SeriousD/SemesterProjekt/Projektbericht/dokumentation.tex

%%%%%%%%%%%%%%%%%%%%%%%%%%%%%%%%%%%%%%%%%
% University Assignment Title Page 
% LaTeX Template
% Version 1.0 (27/12/12)
%
% This template has been downloaded from:
% http://www.LaTeXTemplates.com
%
% Original author:
% WikiBooks (http://en.wikibooks.org/wiki/LaTeX/Title_Creation)
%
% License:
% CC BY-NC-SA 3.0 (http://creativecommons.org/licenses/by-nc-sa/3.0/)
% 
% Instructions for using this template:
% This title page is capable of being compiled as is. This is not useful for 
% including it in another document. To do this, you have two options: 
%
% 1) Copy/paste everything between \begin{document} and \end{document} 
% starting at \begin{titlepage} and paste this into another LaTeX file where you 
% want your title page.
% OR
% 2) Remove everything outside the \begin{titlepage} and \end{titlepage} and 
% move this file to the same directory as the LaTeX file you wish to add it to. 
% Then add \input{./title_page_1.tex} to your LaTeX file where you want your
% title page.
%
%%%%%%%%%%%%%%%%%%%%%%%%%%%%%%%%%%%%%%%%%
%\title{Title page with logo}
%----------------------------------------------------------------------------------------
%   PACKAGES AND OTHER DOCUMENT CONFIGURATIONS

%----------------------------------------------------------------------------------------

\documentclass[12pt]{article}
\usepackage[ngerman]{babel}
\usepackage[utf8x]{inputenc}
\usepackage{amsmath}
\usepackage{graphicx}
\usepackage[colorinlistoftodos]{todonotes}
\usepackage{float}
\restylefloat{table}
\usepackage{floatflt} 
\usepackage{fancyhdr}
\usepackage{subfigure}
\usepackage{microtype}
\usepackage{pdfpages}

\usepackage{pgfplots}
\usepackage{booktabs}

\setlength{\emergencystretch}{1em}
%\usepackage{showframe}% just for the example

%\usepackage{gnuplot-lua-tikz}
%\usepackage{pgfsys}
%\usepackage{keyval}
%\usepackage{xcolor}
%\usepackage{tikz}

\begin{document}
\begin{titlepage}

\newcommand{\HRule}{\rule{\linewidth}{0.5mm}} % Defines a new command for the horizontal lines, change thickness here

\center % Center everything on the page
%----------------------------------------------------------------------------------------
%   HEADING SECTIONS
%----------------------------------------------------------------------------------------

\textsc{\LARGE University of applied sciences Kiel}\\[1.5cm] % Name of your university/college
\textsc{\Large Semesterprojekt}\\[0.5cm] % Major heading such as course name
\textsc{\large }\\[0.5cm] % Minor heading such as course title

%----------------------------------------------------------------------------------------
%   TITLE SECTION
%----------------------------------------------------------------------------------------

\HRule \\[0.4cm]
{ \huge \bfseries Optische Übertragungsstrecke für das Hochspannungslabor im Fachbereich I\&E}\\[0.4cm] % Title of your document
\HRule \\[1.5cm]
 
%----------------------------------------------------------------------------------------
%   AUTHOR SECTION
%----------------------------------------------------------------------------------------

\begin{minipage}{0.4\textwidth}
\begin{flushleft} \large
\emph{Autor:}\\
Clemens \textsc{Büsch}\\
Dennis \textsc{Ernst}
\end{flushleft}
\end{minipage}
~
\begin{minipage}{0.4\textwidth}
\begin{flushright} \large
\emph{Betreuer:} \\
Prof. Dr. Kay \textsc{Rethmeier} % Supervisor's Name
\end{flushright}
\end{minipage}\\[2cm]

% If you don't want a supervisor, uncomment the two lines below and remove the section above
%\Large \emph{Author:}\\
%John \textsc{Smith}\\[3cm] % Your name

%----------------------------------------------------------------------------------------
%   DATE SECTION
%----------------------------------------------------------------------------------------

{\large \today}\\[2cm] % Date, change the \today to a set date if you want to be precise
	
\newcommand{\CM}[1]{\makebox[0pt]{\begin{tabular}{l}#1\end{tabular}}} 
%----------------------------------------------------------------------------------------
%   LOGO SECTION
%----------------------------------------------------------------------------------------

%\includegraphics{logo.png}\\[1cm] % Include a department/university logo - this will require the graphicx package
 
%----------------------------------------------------------------------------------------

\vfill % Fill the rest of the page with whitespace

\end{titlepage}
%\pagestyle{fancy}
%\lfoot{\textsc{Semesterprojekt}:\\ {\footnotesize Optische Übertragungsstrecke für das Hoch-\\spannungslabor im Fachbereich I\&E}}

\tableofcontents

\newpage

\input{einleitung}
\input{uebertragsungsverfahren}
\input{projektstruktur}
\input{vcc}
\input{eingangstufe}
\input{millerintegrator}
\input{comp}
\input{diodentreiber}

\input{demodulation}
\input{recv}
\input{preamp}
\input{tiefpass}
\input{endstufe}

\input{simTx}
\input{simRx}

\input{measurements}
\input{justierung}
\input{appendix}

\listoffigures

\end{document}
