SeriousD/SemesterProjekt/Projektbericht/uebertragsungsverfahren.tex

\section{Übertragungsverfahren}
Das zu übertragende Signal ist ein analoges Messignal mit Netzfrequenz, welches von der Hochspannungsanlage stammt. Die Amplitude wird durch den Eingangswiderstand der Sendeeinheit bestimmt. Die zur Verfügung stehenden Dioden können analoge sowie digitale Signale übertragen. Aufgrund dessen stehen mehrere Übertragungsverfahren zur Auswahl.
In diesem Kapitel werden einige in Frage kommende Übertragungsverfahren vorgestellt und evaluiert.
\subsection{Analoge Übertragungsarten}
\subsubsection{Direkte Übertragung}
Eine Möglichkeit das Signal zu übertragen ist, dieses nach Aufbereitung direkt auf die Dioden zu geben.
Durch diese Anordnung ist jedoch nicht garantiert, dass das Messignal bei variierender Länge des Lichtwellenleiters mit gleicher Amplitude rekonsturiert werden kann. Die Dämpfung des Lichtwellenleiters erfordert eine Kalibration auf verschiedene Längen der Übertragungs\-strecke.
\subsubsection{Frequenzmodulation}
\begin{figure}[H]
\centering
  %\scalebox{0.7}{\begin{large}$\input{fm.tex}$\end{large}}
  \input{gfx/modulations/FM.pgf}
  \caption{Frequenzmodulation}
  \label{fig:fm}
\end{figure}
Die Frequenzmodulation verändert die Frequenz des Trägersignals linear zur Amplitude des Nachrichtensignals.
Eine Implementierung einer solchen Modulation ist mit einem Voltage contolled oscillator (VCO) simpel zu realisieren. Die Demodulation erfolgt über einen Diskriminator, welcher auf vielfältige Art und Weise aufgebaut werden kann. Exemplarisch sei an dieser Stelle die Demodulation mit einem Phase locked loop (PLL) genannt. Eine PLL führt die Ausgangsfrequenz immer einer gegeben Eingangsfrequenz nach. Die Regeldifferenz aus diesen Größen lässt sich als Spannung abgreifen. Wird ein frequenzmoduliertes Signal als Soll-Signal vorgegeben so ist die genannte Regelspannung das demodulierte Nachrichtensignal.

\subsubsection{Amplitudenmodulation}
\begin{figure}[H]
\centering
  %\scalebox{0.7}{\begin{large}$\input{am.tex}$\end{large}}
  \input{gfx/modulations/AM.pgf}
  \caption{Amplitudenmodulation}
  \label{fig:am}
\end{figure}
Die Amplitudenmodulation verändert die Amplitude des Trägersignals proportional zum Nachrichtensignal.
Eine Amplitudenmodulation lässt sich durch Anwendung eines 4 Quadranten-Mischers unkompliziert implementieren. Zur Modulation werden lediglich ein Trägersignal, welches eine vielfache Frequenz des Nachrichtensignals haben muss, und das Nachrichtensignal multiplizert. Anschließend werden unerwünsche Mischprodukte herausgefiltert. Die Demodulation erfolgt über einen Tiefpass, dessen Grenzfrequenz weit unter der gewählten Trägerfrequenz liegt.
Da bei dieser Modulation die Information genauso wie bei der direkten Übertragung in der Amplitude liegt, entstehen wieder die gleichen Probleme durch die Dämpfung des Lichtwellenleiters.

\subsection{Digitale Übertragungsarten}
\subsubsection{Pulsweitenmodulation}
\begin{figure}[H]
\centering
  %\scalebox{0.7}{\begin{large}
  %$\input{pwm.tex}$
  %\end{large}}
  \input{gfx/modulations/PWM.pgf}
  \caption{Pulsweitenmodulation}
  \label{fig:pwm}
\end{figure}
Die Pulsweitenmodulation moduliert, ähnlich wie die Frequenzmodulation, das Nachrichtensignal im Zeitbereich. 
Die essentiellen Unterschiede liegen zum Einen darin, dass die PWM ein digitales Übertragungsverfahren ist und demnach nur 2 Zustände kennt, und zum Anderen, dass das Nachrichtensignal nicht direkt in der Frequenz sondern in der Pulsweite des Trägersignals kodiert wird. Die Synthese einer Pulsweitenmodulation kann durch den Vergleich des Nachrichtensignals mit einer Dreiecksspannung erfolgen. Hierbei ist darauf zu achten, dass die Dreieckspannung, welche als Träger verwendet wird, eine vielfache Frequenz des Nachrichtensignals aufweist. Die Demodulation eines pulsweitenmodulierten Signals erfolgt durch einen Tiefpass, welcher ledglich das Nachrichtensignal im Passband hat. 

\subsection{Wahl des Übertragungsverfahren}
Eine unmodulierte Übertragung ist aufgrund der Leitungsdämpfung ausgeschlossen. Entsprechend kommt folgender genereller Systemaufbau in Frage.
\begin{figure}[H]
\centering
  \input{prinzip.pdf_tex}
  \caption{Genereller Systemaufbau}
  \label{fig:psystem}
\end{figure}
Die Evaluation der drei verbliebenen Varianten liefert die Pulsweitenmodulation (PWM) als optimales Ergebnis:Im Gegensatz zu allen analogen Übertragungsverfahren lässt sich die PWM durch Übersteuerung des Eingangsverstärkers der Empfängereinheit sehr einfach rekonstruieren und ist demnach unempfindlich gegenüber Variationen der Dämpfung der Leitungslänge. Darüber hinaus ist die Synthese sowie Demodulation einer PWM mit einfachen Mitteln umzusetzen.\\
Neben den grundlegenden Aufgaben des Systems, wie Modulation und Demodulation, müssen noch weitere Komponenten wie eine Endstufe und eine Schutzschaltung gegenüber der Hochspannung im System verbaut werden. 
Aus allen vorangegangen Überlegungen geht folgender Systemaufbau hervor: 
\begin{figure}[H]
  \centering
  \scalebox{0.97}{
  \input{systemaufbau.pdf_tex}}
  \caption{Systemaufbau}
  \label{fig:system}
\end{figure}

\subsection{Pulsweitenmodulation - Theorie}
\label{sec:pwmTheory}
Im wesentlichen basiert die Funktionsweise einer PWM auf der Variation des Tastverhältnisses einer Rechteckspannung. Durch die Änderung des Tastverhältnis wird der Effektivwert der Rechteckspannung verändert, dieser berechnet sich wie folgt:
\begin{equation}
 U_{eff} = \sqrt{\frac{1}{T}\cdot\int\limits_{0}^T u(t)^2 dt}
\end{equation}
Offensichtlich ist der Effektivwert von dem Integral der Kurve über eine Periode, also der Fläche unter der Kurve, abhängig. Diese Fläche wird wie bereits beschrieben über das Tastverhältnis bestimmt. So kann jede Perdiode des Rechteckssignals als ein Abstastwert des Nachrichtensignals interpretiert werden. Dieses Integral ist beispielhaft für 2 Perioden eines Sinussignals in Abbildung \ref{fig:pwmArea} dargestellt. Aufgrund dieser Abtastung ist es wichtig, dass zur optimalen Rekonstruktion das 50 Hz Eingangssignal um ein Vielfaches abgetastet wird. Für diese Anwendung wurde eine 200-fache Überabtastung von $f_A=10kHz$ gewählt.
\begin{figure}[H]
  \centering
   %\scalebox{0.6}{\begin{Large}
   %\input{pwmArea.tex}
   %\end{Large}}
   \input{gfx/modulations/PWMarea.pgf}
   \caption{Pulsweitenmodulation Illustration}
  \label{fig:pwmArea}
\end{figure}

\newpage
