SeriousD/SemesterProjekt/Projektbericht/projektstruktur.tex

\section{Projektstruktur}
Das Projekt wird in folgende Teilprobleme zerlegt. 
\begin{figure}[H]
\centering
  \scalebox{0.85}{
 \input{projektstruktur.pdf_tex}}
	\caption{Projektstruktur}
\end{figure}
Im Laufe der Projektarbeit wird jedes einzelne Teilproblem mit Komponententests validiert. Schlussendlich wird das Gesamtsystem getestet.
