SeriousD/SemesterProjekt/Projektbericht/dokumentation.pdf

University of applied sciences Kiel

Semesterprojekt

# Optische Ubertragungsstrecke ¨ fur das Hochspannungslabor im ¨ Fachbereich I&E

### Autor: Clemens Busch ¨ Dennis Ernst

### Betreuer: Prof. Dr. Kay

Rethmeier

### 21. Februar 2017

## Inhaltsverzeichnis

1 Einleitung | | 2
2 Ubertragungsverfahren | 2 ¨
2.1 Analoge Ubertragungsarten | ¨ | 2
2.1.1 | Direkte Ubertragung | ¨ | 2
2.2 Digitale Ubertragungsarten | ¨ | 5
2.3 Wahl des Ubertragungsverfahren | ¨ | 6
3 Projektstruktur | 8
4 Schaltungsentwurf - Sendeeinheit | 8
5 Schaltungsentwurf - Empfangseinheit | 13
6 Simulation kritischer Schaltungsteile | 22

1

## 1 Einleitung

Im Hochspannungslabor des Fachbereichs Informatik und Elektrotechnik werden die Messsignale aus dem zum elektrischen Schutz aufgebauten Hochspannungskäfig per BNC Leitung nach außen an die Messgeräte gefuhrt. ¨ Die Messgeräte und insbesondere die zufuhrenden Leitungen haben keinen ¨
Beruhrungsschutz, was unmittelbar ein Gefahrenpotential f ¨ | ur die Experimen- ¨
tatoren durch Uberschl ¨ | äge in die Messleitung birgt.
Aufgrund dieser Gefahr soll eine optische Signalsubertragungsstrecke mit ei- ¨ nem Lichtwellenleiter realisiert werden.
Zur Verfugung stehen dazu Hochgeschwindigkeitssende- und Empfangsdi- ¨ oden von des Herstellers Avago (HFBR1414 und HFBR2416).

## 2 Ubertragungsverfahren ¨

Das zu ubertragende Signal ist ein analoges Messignal mit Netzfrequenz, ¨ welches von der Hochspannungsanlage stammt. Die Amplitude wird durch den Eingangswiderstand der Sendeeinheit bestimmt. Die zur Verfugung ste- ¨ henden Dioden können analoge sowie digitale Signale ubertragen. Aufgrund ¨ dessen stehen mehrere Ubertragungsverfahren zur Auswahl. In diesem Kapi- ¨ tel werden einige in Frage kommende Ubertragungsverfahren vorgestellt und ¨ evaluiert.

### 2.1 Analoge Ubertragungsarten ¨

### 2.1.1 Direkte Ubertragung ¨

Eine Möglichkeit das Signal zu ubertragen ist, dieses nach Aufbereitung di- ¨ rekt auf die Dioden zu geben. Durch diese Anordnung ist jedoch nicht garantiert, dass das Messignal bei variierender Länge des Lichtwellenleiters mit gleicher Amplitude rekonsturiert werden kann. Die Dämpfung des Lichtwellenleiters erfordert eine Kalibration auf verschiedene Längen der Ubertragungs- ¨ strecke.

2

### 2.1.2 Frequenzmodulation

-15

-10

-5

0

5

10

15

0 | 0.01 | 0.02 | 0.03 | 0.04 | 0.05 | 0.06

-6

-4

-2

0

2

4

6

0 | 0.01 | 0.02 | 0.03 | 0.04 | 0.05 | 0.06

-6

-4

-2

0

2

4

6

0 | 0.01 | 0.02 | 0.03 | 0.04 | 0.05 | 0.06

u

m/V

t/s

Nachrichtensignal

uc/V

t/s

Trägersignal

ufm/V

t/s

Frequenzmoduliertes Signal

Abbildung 1: Frequenzmodulation

Die Frequenzmodulation verändert die Frequenz des Trägersignals linear zur Amplitude des Nachrichtensignals. Eine Implementierung einer solchen Modulation ist mit einem Voltage contolled oscillator (VCO) simpel zu realisieren. Die Demodulation erfolgt uber einen Diskriminator, welcher auf ¨ vielfältige Art und Weise aufgebaut werden kann. Exemplarisch sei an dieser Stelle die Demodulation mit einem Phase locked loop (PLL) genannt. Eine PLL fuhrt die Ausgangsfrequenz immer einer gegeben Eingangsfrequenz ¨ nach. Die Regeldifferenz aus diesen Größen lässt sich als Spannung abgreifen. Wird ein frequenzmoduliertes Signal als Soll-Signal vorgegeben so ist die genannte Regelspannung das demodulierte Nachrichtensignal.

3

### 2.1.3 Amplitudenmodulation

-15

-10

-5

0

5

10

15

0 | 0.01 | 0.02 | 0.03 | 0.04 | 0.05 | 0.06

-6

-4

-2

0

2

4

6

0 | 0.01 | 0.02 | 0.03 | 0.04 | 0.05 | 0.06

-30

-20

-10

0

10

20

30

0 | 0.01 | 0.02 | 0.03 | 0.04 | 0.05 | 0.06

u

m/V

t/s

Nachrichtensignal

uc/V

t/s

Trägersignal

uam/V

t/s

Amplitudenmoduliertes Signal

Abbildung 2: Amplitudenmodulation

Die Amplitudenmodulation verändert die Amplitude des Trägersignals proportional zum Nachrichtensignal. Eine Amplitudenmodulation lässt sich durch Anwendung eines 4 Quadranten-Mischers unkompliziert implementieren. Zur Modulation werden lediglich ein Trägersignal, welches eine vielfache Frequenz des Nachrichtensignals haben muss, und das Nachrichtensignal multiplizert. Anschließend werden unerwunsche Mischprodukte herausgefiltert. Die De- ¨ modulation erfolgt uber einen Tiefpass, dessen Grenzfrequenz weit unter der ¨ gewählten Trägerfrequenz liegt. Da bei dieser Modulation die Information genauso wie bei der direkten Ubertragung in der Amplitude liegt, entstehen ¨ wieder die gleichen Probleme durch die Dämpfung des Lichtwellenleiters.

4

### 2.2 Digitale Ubertragungsarten ¨

### 2.2.1 Pulsweitenmodulation

-15

-10

-5

0

5

10

15

0 | 0.01 | 0.02 | 0.03 | 0.04 | 0.05 | 0.06

-15

-10

-5

0

5

10

15

0 | 0.01 | 0.02 | 0.03 | 0.04 | 0.05 | 0.06

-0.5

0

0.5

1

1.5

0 | 0.01 | 0.02 | 0.03 | 0.04 | 0.05 | 0.06

u

m/V

t/s

Nachrichtensignal

uc/V

t/s

Trägersignal

upwm/V

t/s

Pulsweitenmoduliertes Signal

Abbildung 3: Pulsweitenmodulation

Die Pulsweitenmodulation moduliert, ähnlich wie die Frequenzmodulation, das Nachrichtensignal im Zeitbereich. Die essentiellen Unterschiede liegen zum Einen darin, dass die PWM ein digitales Ubertragungsverfahren ist und ¨ demnach nur 2 Zustände kennt, und zum Anderen, dass das Nachrichtensignal nicht direkt in der Frequenz sondern in der Pulsweite des Trägersignals kodiert wird. Die Synthese einer Pulsweitenmodulation kann durch den Vergleich des Nachrichtensignals mit einer Dreiecksspannung erfolgen. Hierbei ist darauf zu achten, dass die Dreieckspannung, welche als Träger verwendet wird, eine vielfache Frequenz des Nachrichtensignals aufweist. Die Demodulation eines pulsweitenmodulierten Signals erfolgt durch einen Tiefpass,

5

welcher ledglich das Nachrichtensignal im Passband hat.

### 2.3 Wahl des Ubertragungsverfahren ¨

Eine unmodulierte Ubertragung ist aufgrund der Leitungsd ¨ | ämpfung ausge-
schlossen. Entsprechend kommt folgender genereller Systemaufbau in Frage.
Modulator | LWL-
Ubertragung ¨

Demodulator Nutzsignal

Trägersignal

Nutzsignal

Trägersignal

Abbildung 4: Genereller Systemaufbau

Die Evaluation der drei verbliebenen Varianten liefert die Pulsweitenmodulation (PWM) als optimales Ergebnis: Im Gegensatz zu allen analo-
gen Ubertragungsverfahren l ¨ | ässt sich die PWM durch Ubersteuerung des ¨
Eingangsverstärkers der Empfängereinheit sehr einfach rekonstruieren und
ist demnach unempfindlich gegenuber Variationen der D ¨ | ämpfung der Lei-
tungslänge. Daruber hinaus ist die Synthese sowie Demodulation einer PWM ¨ mit einfachen Mitteln umzusetzen.
Neben den grundlegenden Aufgaben des Systems, wie Modulation und Demodulation, mussen noch weitere Komponenten wie eine Endstufe und eine ¨ Schutzschaltung gegenuber der Hochspannung im System verbaut werden. ¨ Aus allen vorangegangen Uberlegungen geht folgender Systemaufbau hervor: ¨

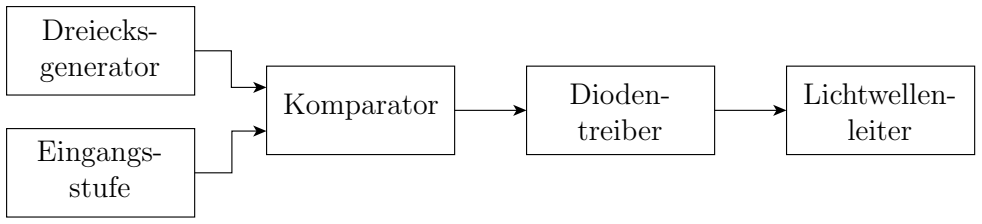
[picture p9: figure]
Komparator; Eingangs- stufe; Dreiecks- generator; Dioden- treiber; Lichtwellen- leiter

Endstufe

Butterworth-tiefpass

Signalaufbereitung

Empfangseinheit:

Sendeeinheit:

Lichtwellenleiter

Abbildung 5: Systemaufbau

6

### 2.4 Pulsweitenmodulation - Theorie

Im wesentlichen basiert die Funktionsweise einer PWM auf der Variation des Tastverhältnisses einer Rechteckspannung. Durch die Anderung des Tast- ¨ verhältnis wird der Effektivwert der Rechteckspannung verändert, dieser berechnet sich wie folgt:

Uef f =

### vuuut

1
T

·

Z

T

0

u(t)

2dt | (1)

Offensichtlich ist der Effektivwert von dem Integral der Kurve uber eine ¨ Periode, also der Fläche unter der Kurve, abhängig. Diese Fläche wird wie
bereits beschrieben uber das Tastverh ¨ | ältnis bestimmt. So kann jede Perdiode
des Rechteckssignals als ein Abstastwert des Nachrichtensignals interpretiert werden. Dieses Integral ist beispielhaft fur 2 Perioden eines Sinussignals in ¨ Abbildung 6 dargestellt. Aufgrund dieser Abtastung ist es wichtig, dass zur optimalen Rekonstruktion das 50 Hz Eingangssignal um ein Vielfaches abge-
tastet wird. Fur diese Anwendung wurde eine 200-fache ¨ | Uberabtastung von ¨
fA = 10kHz gewählt.

-0.5

0

0.5

1

1.5

0 | 0.005 | 0.01 | 0.015 | 0.02 | 0.025 | 0.03 | 0.035 | 0.04

upwm/V

t/s

Pulsweitenmoduliertes Signal

Abbildung 6: Pulsweitenmodulation Illustration

7

## 3 Projektstruktur

Das Projekt wird in folgende Teilprobleme zerlegt.

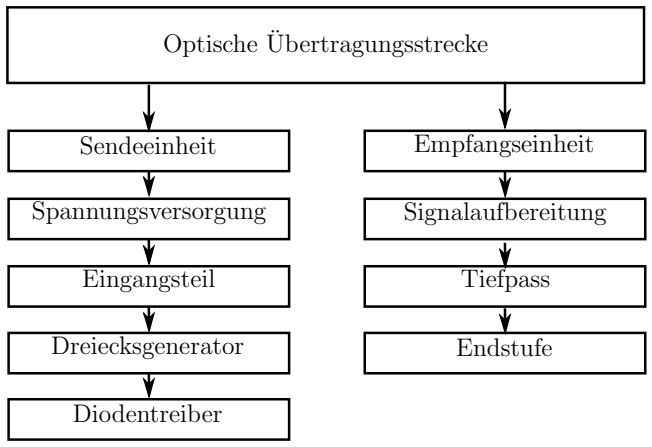
[picture p10: figure]
Optische Ubertragungsstrecke ¨; Sendeeinheit; Empfangseinheit; Signalaufbereitung; Endstufe; Spannungsversorgung; Eingangsteil; Dreiecksgenerator; Diodentreiber; Tiefpass

Abbildung 7: Projektstruktur

Im Laufe der Projektarbeit wird jedes einzelne Teilproblem mit Komponententests validiert. Schlussendlich wird das Gesamtsystem getestet.

## 4 Schaltungsentwurf - Sendeeinheit

### 4.1 Spannungsversorgung

Die Spannungsversorgung fur die Sen- ¨

Ext. Supply

7809

7909 | GND

X2-1 1

X2-2 2

X2-3 3

GND

VI 1

2

VO 3

GND
VI 2

1
VO 3

V+

V-

Abbildung 8: Spannungsversorgung deeinheit erfolgt zur galvanischen Trennung uber Batterien. Aufgrund der ho- ¨ hen Stromaufnahme durch die Sendediode sowie der Status-LEDs ist eine interne Versorgung uber 9V Blockbat- ¨ terien nur bedingt möglich. Deswegen
wird auf eine externe Versorgng uber ¨
12V Akkus zuruckgegriffen. Damit die ¨
Schaltung dennoch bei allen Akkuspannungen zuverlässig und mit gleichen Ergebnissen arbeitet wird die Spannung intern auf 9V stabilisiert.

8

### 4.2 Eingangsstufe

SL2

1

2

3

R1 | R5
A | E

S R11

AE

S

R12

R13 | D2 D3
F1

C8
AC_IN
1k | 1k

50k

20k
S14K11
7,5

7,5

100n

GND | GND

Abbildung 9: Kaskade

Die Eingangsstufe der Sendeeinheit dient einerseits zur Einstellung der gewunschten ¨ Impedanz und andererseits der Schaltung der folgenden Komponenten. Beiden Potentiometer (R12 , R13) werden durch einen Kippschalter an der Front
des Geräts umgeschaltet. Die folgenden 3 Schaltungsteile, welche durch 1kΩ Widerstände miteinander verbunden sind dienen dem Kurzschluss von Uberspannungen. ¨ Der Gasableiter ist mit einer Druchbruchspannung von 60V gewählt, der Varistor S14K11 ist mit einer AC-Durchbruchspannung von 11V gewählt und
die Zenerdioden mit einer Zenerspannung von 7, 5V dimensioniert.
Diese Schaltungs-Topologie sorgt fur einen zuverl ¨ | ässigen Schutz gegenuber ¨
Uberspannungen. Die Zener-Dioden, schalten am schnellsten und sind ent- ¨ sprechend am nähesten zur zu schutzenden Komponente verortet. Der Va- ¨ ristor spricht langsamer als die Zener-Dioden an, jedoch schneller als der Gasableiter. Die einzelnen Schutzbauteile sind der Verlustleistung und der Ansprechzeit nach absteigend in Richtung der folgenden Schaltungsteile angeordnet.

Abbildung 10: Spannungsversorgung

egergsfgsreghtsrhdt

9

### 4.3 Dreiecksgenerator

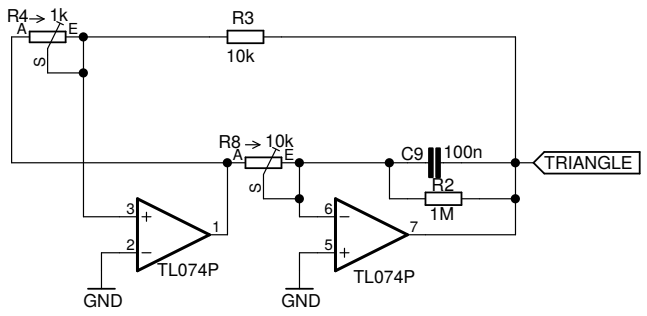
[picture p11: figure]
TRIANGLE; GND

Abbildung 11: Miller Integrator

Fur die Generierung eines Dreiecksignals wurde ein Miller-Integrator verwen- ¨ det. Die Grundlage fur die Schaltung liegt in einer Applicationnote von TI ¨

1
Das Grundprinzip dieser Schaltung besteht aus einem Intergrator, welcher auf einen invertierenden Schmitt-Trigger ruckgekoppelt ist. Der linke Ope- ¨ rationsverstärker bildet mit R4 und R3 den Schmitt-Trigger. Der Integrator besteht aus R8,C1 und dem rechten Operationsverstärker in Abbildung 12. Frequenzbestimmend sind in dieser Schaltung alle Bauteile. Durch R4 und R3 werden die Schaltschwellen, und damit die Amplitude bestimmt. Diese berechnet sich wie folgt:

UH = ±

R3
R4
- Vcc | (2)

Mit R8 und C1 wird die Flankensteilheit(k) in V
s

bestimmt:

k =

Vcc
R8 · C1

(3)

Die Frequenz des Dreieckssignals berechnet sich zu:

f =

R4
4 · R8 · R3 · C1

(4)

C1 wurde mit 33nF fest gewählt. Uein ist die Betriebspannung(Vcc), welche mit 9V gewählt wurde.

1Texas Instruments,Appnote 20, Seite 24, www.ti.com/lit/an/snoa621c/snoa621c.pdf

10

### 4.4 Komparator

Der Komparator bildet das Kernstuck ¨

TL074

13

12

### 14 TRIANGLE SIGNAL

### PWM

Abbildung 12: Komparator

zur Pulsweitenmodulation. Im wesentlichen vergleicht diese Komponente das im Dreiecksgenerator erzeugte Signal
mit dem Eingangssignal und generiert
damit die PWM (vgl. Abbildung 3).
Die Spezifikationen des fur diese Aufgabe gew ¨ | ählten Operationsverstärkers
sind von großer Bedeutung fur die Funktionsf ¨ | ähigkeit und Skalierbarkeit des
Gesamtsystems. Neben dem Stromverbrauch, der Betriebsspannung und der Slew-Rate ist auch die Beschaffbarkeit des Operationsvertärkers ein entschei-
dender Faktor. Fur diese Anwendung wurde deswegen der TL074 gew ¨ | ählt,
dieser zum einen durch die verwendete MOS-Technologie eine geringe Stromaufnahme von < 14mA aufweist und zum Anderen mit einer Slew-Rate von 1V/µs fur diese Anwendung bestens geeignet ist. ¨

### 4.5 Diodentreiber

Als Sendediode wird die Hochleistungs-

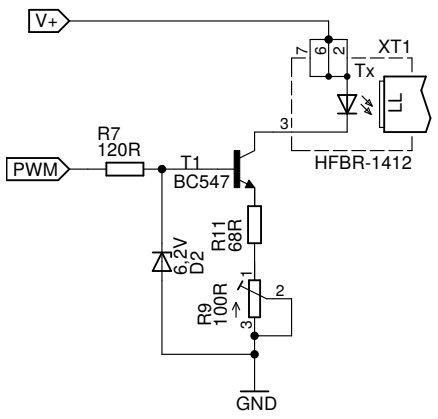
[picture p12: figure]
HFBR-1412; GND; PWM

Abbildung 13: Diodentreiber diode HFBR-1412 verwendet. Diese benötigt minimal 30mA und maximal 120mA. Da eine Diode ein Halbleiter ist, hat diese iene exponentielle Spannungs-Strom Kennlinie. Bei einer Versorgung mit konstanter Spannung kann durch thermische Ruckkopplung der Strom, ¨ und damit die Verlustleistung, unkontrolliert ansteigen. Dies kann zur Zerstörung des Bauteils fuhren. Aufgrund ¨ dessen wird der Diodentreiber als Konstantstromquelle (KSQ) ausgefuhrt. ¨
Die KSQ besteht aus T1, R11, R9 und
D2. Der Widerstand R7 dient lediglich der Begrenzung des Basisstromes von T1 und der Strombegrenzung von D2. Die Zener-Diode D2 hält die Spannung
uber der BE-Strecke von ¨ | T1 und den Widerständen R11 und R9 konstant. Da
die Spannng uber den Widerst ¨ | änden konstant ist, ist auch der Strom durch

11 diese konstant. Daraus folgt, dass auch der Kollektorstrom von T1 und somit auch der Strom durch die Leistungsdiode konstant ist. Der Strom berechnet sich wie folgt.

Ikonst =

Uz − UBE
R9 + R11

(5)

Durch den Reihenwiderstand R11 ist sichergestellt, dass auch bei Anschlag der Potentiometers zu 0Ω der Strom nicht 130mA ubersteigt. Der gesamte ¨
Einstellbereich fur den Diodenstrom liegt bei 36 ¨ | mA < Ikonst < 110mA.

## 5 Schaltungsentwurf - Empfangseinheit

Die Demodulation des Signals erfolgt im wesentlichen durch eine Tiefpass-Filterung. Das gesendete Signal muss allerdings erst vorbereitet werden. Dies geschieht durch eine Vorfilterung und anschließende Verstärkung. Ein Hochpass direkt am Ausgang der Empfangsdiode filtert DC-Anteile. Danach wird die Signalamplitude soweit verstärkt, dass der Signalverlauf wieder komplett
rechteckig dem urspruglichen PWM-Signal entsprechend verl ¨ | äuft. Dadurch
wird die nachfolgende rekonstruierende Filterung durch den Butterworth-Tiefpass erst möglich.
Schlussendlich wird das zuruckgewonnene Signal nach dem Rekonstruktions- ¨ filter mit einer einstellbaren Endstufe final verstärkt, damit die Amplitude dem des gesendeten Signals entspricht.

### 5.1 Beschaltung der Empfangsdiode

Fur die Empfangsdiode ¨ | AVAGO HFBR-2416 ist folgendes Prinzipschalt-
bild aus dem Datenblatt² gegeben:

2Avago, HFBR-2416, Seite 23, Figure 12 http://docs.avagotech.com/docs/AV02-0176EN

12

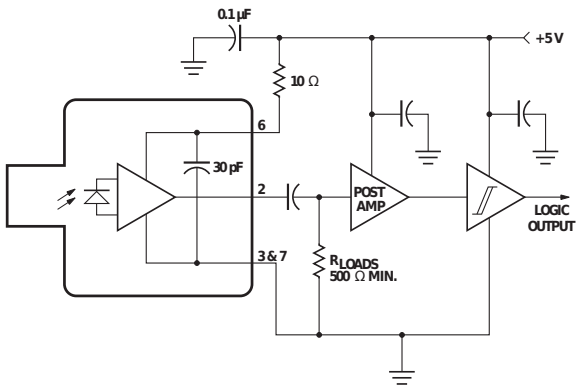
[picture p13: figure]
LOGIC OUTPUT; RLOADS 500 Ω MIN.; POST AMP

Abbildung 14: Prinzipschaltbild Empfangsdiode

Die | Prinzipschaltung | wurde
ubernommen, um den Betrieb ¨
innerhalb | der | Spezifikationen
zu gewährleisten. Die Bauteile sind so dimensioniert, dass die
Grenzfrequenz | des | Hochpasses
aus R4 und C5 unter dem Nachrichtensignal bei 50Hz liegt. Der Hochpass dient der Filterung von DC-Offsets seitens der Diode.
Fur ¨ | R4 | wurde 33kΩ gewählt.
Damit ergibt sich eine neue Grenzfrequenz von fg = 48, 23Hz.

Berechnung des Hochpasses:

Mit C5 = 100nF und fg = 50Hz folgt:

fg =

1
2π · R · C

(6)

R =

1
2π · fg · C

(7)

R =

1
2π · 50Hz · 100nF

(8)

= 31, 83kΩ | (9)

13

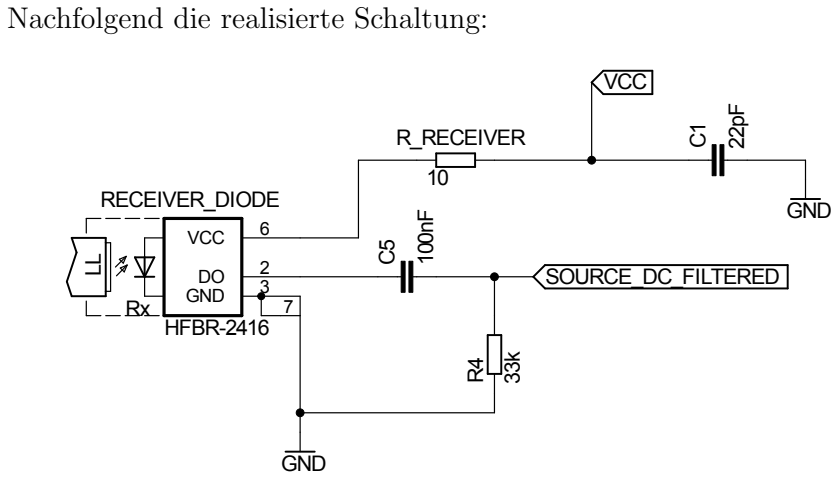
[picture p14: figure]
Nachfolgend die realisierte Schaltung:; GND; HFBR-2416; R_RECEIVER R⁴; RECEIVER_DIODE; VCC; SOURCE_DC_FILTERED

Abbildung 15: Beschaltung Empfangsdiode

14

### 5.2 Signalaufbereitung

Aufgrund der Leitungsdämpfung muss die Amplitude des modulierten Signals vor der Filterung durch den Rekonstruktionsfilter verstärkt werden (siehe Kapitel 5.1 - Abbildung 15: Postamp).Das Signal wird uber einen ¨

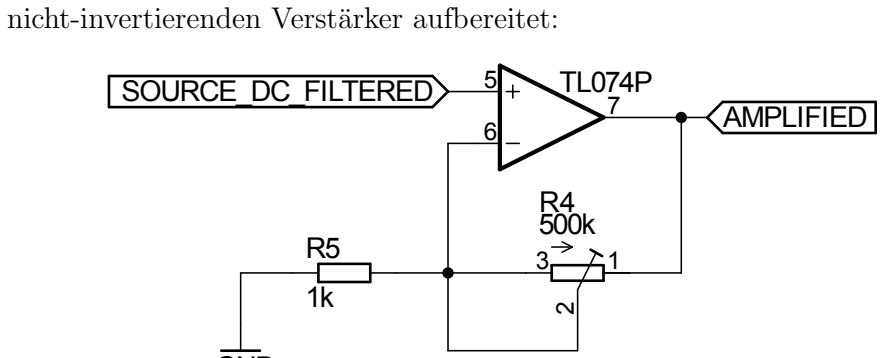
[picture p15: figure]
nicht-invertierenden Verstärker aufbereitet:; AMPLIFIED SOURCE_DC_FILTERED

### GND

Abbildung 16: Vorverstärker

Damit die Schaltung fur verschiedene Leitungsl ¨ | ängen skalierbar ist, wurde
eine variable Verstärkung bis zu einem Faktor von Vu = 500 gewählt.

VU = 1 +

R4
R5

(10)

R4
R5
>> 1 | (11)

VU ≈

R4
R5

(12)

Fur große Verst ¨ | ärkungen errech-
net(siehe Formel12³
) ist die 1 beim
Nicht-Invertierenden Verstärker zu vernachlässligen. Die Verstärkung berechnet sich lediglich aus den beiden Widerständen R5 und R4.

Mit 0Ω < R4 < 500kΩ und R5 = 1kΩ ist die Verstärkung von 0 bis 500 einstellbar.

Neben der Signalaufbereitung fur die folgende Demodulation, wird das ver- ¨ stärkte Signal auch fur eine Signaldetektion aufbereitet. Zur Signalisierung ¨ wird eine Leuchtdiode an der Gehäusefront verwendet. Zur Glättung der Spannung wird ein Kondensator parallel zu der Leuchtdiode mit Vorwiderstand geschaltet. Eine weitere Aufbereitung ist an dieser Stelle nicht not-

3Quelle: Elektronik Vorlesungssunterlagen, Prof. Dr. Ralf Patz

15 wendig, da das Trägersignal, als auch das Nachrichtensignal ≥ 50Hz ist und somit fur das menschliche Auge kein Flackern auftritt. ¨

16

### 5.3 Tiefpass

Die Dimensionierung des Tiefpasses ist von zentraler Bedeutung bei der Rekonstruktion des Nachrichtensignals. Neben der Filtersteilheit und der Restwelligkeit sind Kennwerte wie Ausgangs- und Eingangswiderstand wichtig fur die optmale Gestaltung des Tiefpasses. ¨

### 5.3.1 Filtercharakteristiken im Vergleich

Bei aktiven und mehrstufigen Fil-

gfx/characteristics.png

Abbildung 18: Filtercharakteristiken tertopologien gibt es eine große Auswahl an Fitlercharakteristiken, welche sich durch verschiedene Eigenschaften auszeichnen. Kennwerte fur ¨ diese Charakteristiken sind Linearphasigkeit, Gruppenlaufzeit, sowie Restwelligkeit im Pass-und Sperrband. In Abbildung 19 sind einige Charakteristiken beispielhaft dargestellt. Fur die Rekonstruktion wird ¨
eine Butterworth-Charakteristik gewählt, da diese im Passband eine konstante Verstärkung aufweist, sowie keinen Peak kurz vor der Grenzfrequenz hat.

### 5.3.2 Dimensionierung des Filters

Zur Dimensionierung des Filters wurde die Designsoftware FilterPro von Texas Instruments verwendet. Als Designparameter wurden neben der Butterworth-Charakteristik, eine Verstärkung von 0dB, eine Dämpfung von 9dB je Dekade (Filter 3. Ordnung), Bauteile der E12 Reihe, eine Grenzfrequenz von fg = 100Hz und eine Multiple-Feedback Topologie vorgegeben. Diese Topologie hat im Gegensatz zur Sallen-Key Topologie den Vorteil eines hohen Ausgangswiderstandes. Die Verstärkung von 0dB wird gewählt, da eine Endstufe mit variabler Verstärkung dieser Komponente folgt.

17


Abbildung 19: Auszug Design Report

Der Designreport zeigt die gewunschten Filterparameter. Besonders wich- ¨ tig an dieser Stelle ist die benötigte Unity-Gain (Gain-Bandwidth-Product), welche sich mit maximal 10kHz innerhalb der Spezifikationen vom TL074
befinden. Daruber hinaus wurde aufgrund besserer Beschaffbarkeit ¨ | C2 zu
1µF gewählt.

18

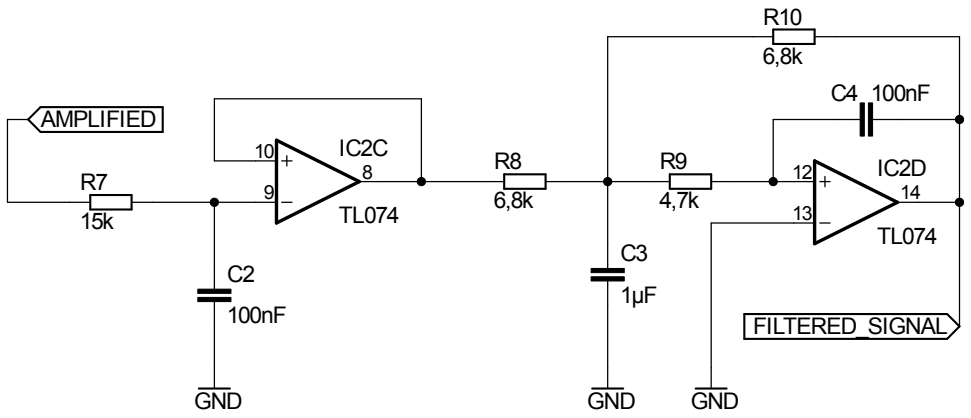
[picture p16: figure]
GND; FILTERED_SIGNAL; AMPLIFIED

Abbildung 20: Butterworth-Tiefpass

Der Widerstand R7 und der Kondensator C2 bilden als passiver Tiefpass die erste Filterstufe. Diese ist mit dem linken Operationsverstärker, welcher als Spannungsfolger beschaltet ist von der nachfolgenden zweiten Filterstufe entkoppelt. Mit R8 und C3 folgt ein weiterer passiver Tiefpass. Der letzte Teil des Filters ist ein aktiver Tiefpass, der sich aus dem zweiten Operationsverstärker und den Widerständen R9 ,R10, sowie dem Kondensator C4 zusammensetzt.

### 5.4 Endstufe

Der letzte Teil der Empfangseinheit besteht aus einem weiteren Verstärker und einem vorgeschalteten Hochpass. Der Hochpass hat eine Grenzfrequenz von fg ≈ 1, 59Hz und dient der Filterung vorangegangener DC-Offsets. Wie in Kapitel 5.2 bereits gezeigt, ist die Verstärkung ausschließlich von den beiden Widerständen abhänging. Die Verstärkung der Endstufe ist somit uber ¨ das Potentiometer von 0 bis 50 einstellbar.

19

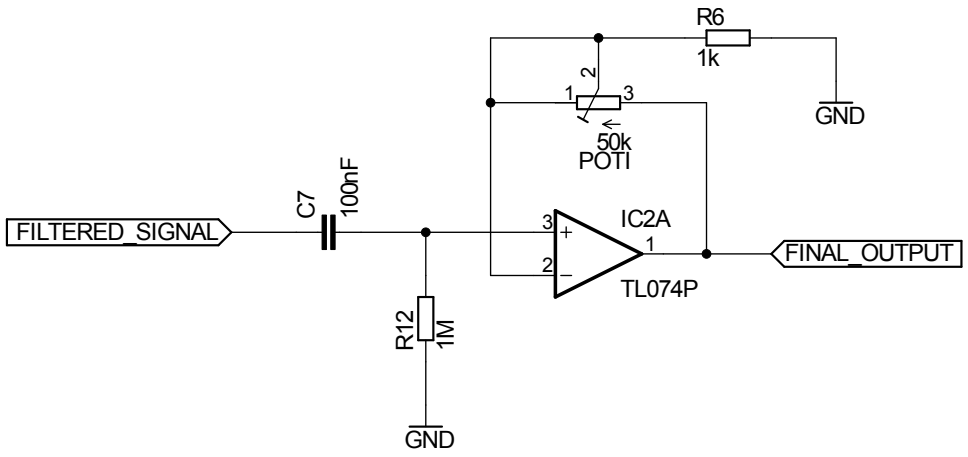
[picture p17: figure]
GND; POTI; FINAL_OUTPUT FILTERED_SIGNAL

Abbildung 21: Endstufe

20

## 6 Simulation kritischer Schaltungsteile

### 6.1 Sendeeinheit

### 6.1.1 Eingangsteil

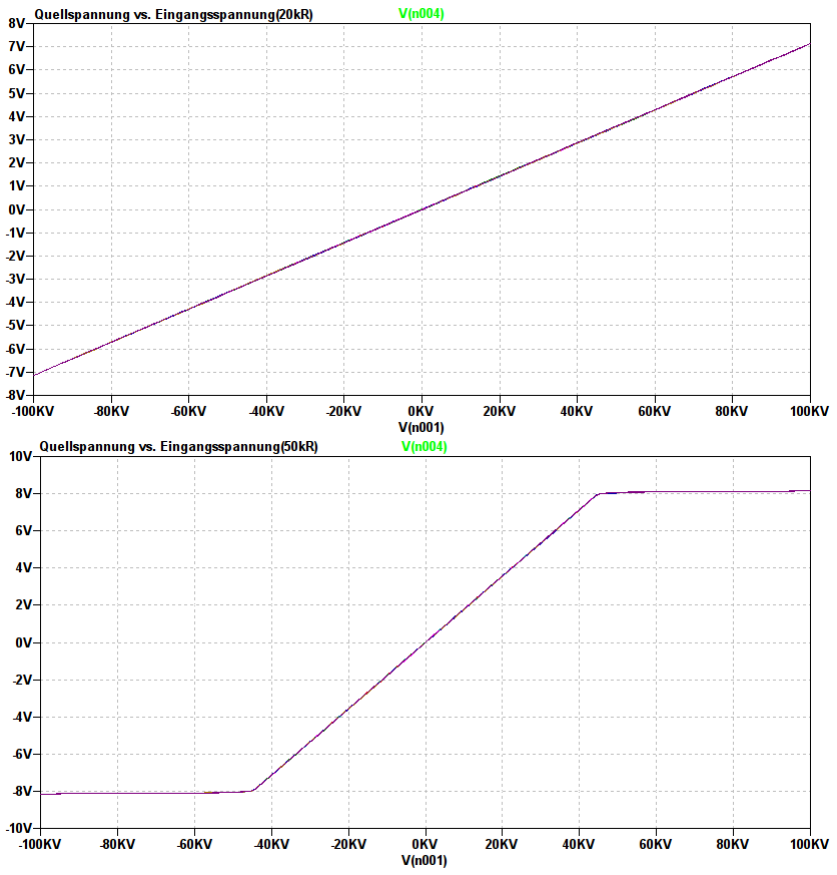
[picture p18: figure]

21

### 6.1.2 Millerintegrator


22

### 6.1.3 Diodentreiber


23

### 6.2 Empfangseinheit

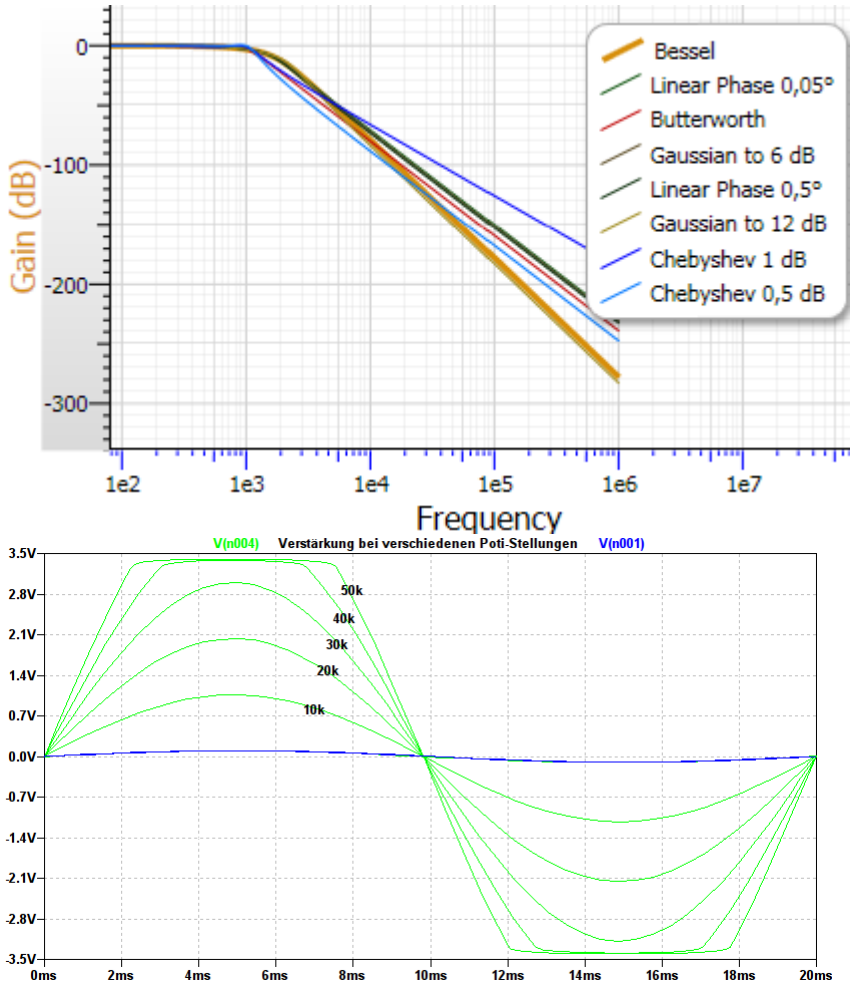
[picture p19: figure]

24

## Abbildungsverzeichnis

25
