SeriousD/SemesterProjekt/Projektbericht/gfx/triangle_generator.pdf

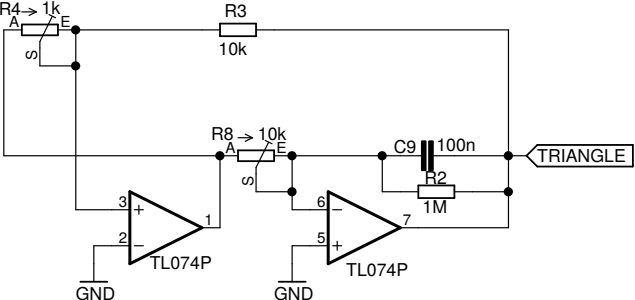
[picture p20: figure]
TRIANGLE; GND
