SeriousD/SemesterProjekt/Projektbericht/gfx/diodentreiber.pdf

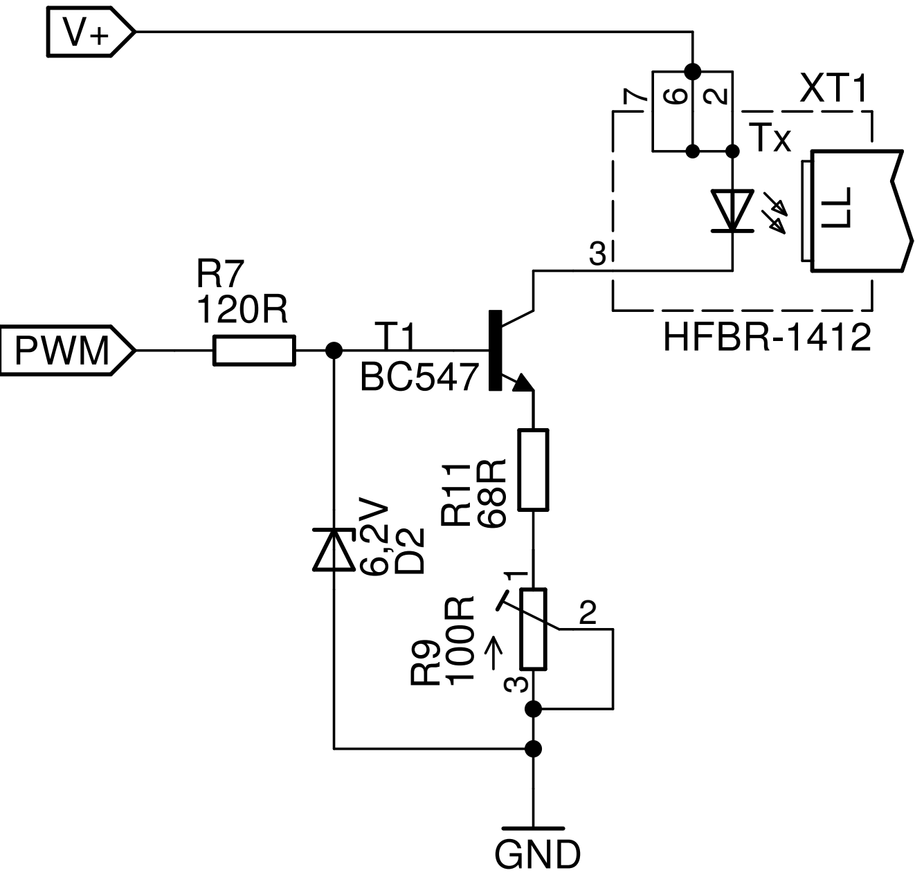
[picture p21: figure]
HFBR-1412; GND; PWM
