SeriousD/SemesterProjekt/Projektbericht/gfx/detect.pdf

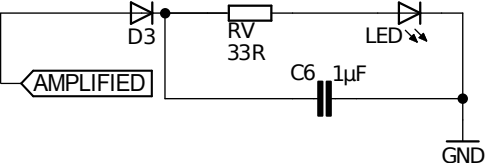
[picture p22: figure]
GND; LED; AMPLIFIED
