SeriousD/SemesterProjekt/Projektbericht/gfx/post_amplifier.pdf

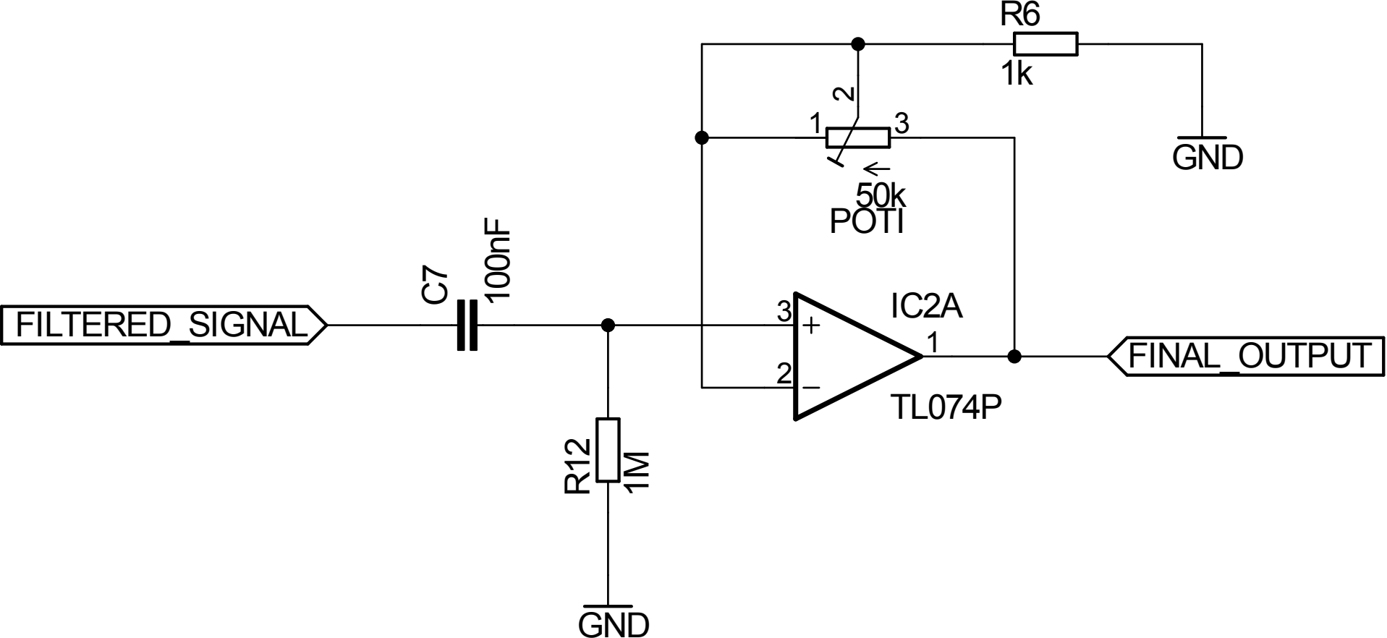
[picture p23: figure]
GND; POTI; FINAL_OUTPUT FILTERED_SIGNAL
