SeriousD/SemesterProjekt/Projektbericht/gfx/preamp.pdf

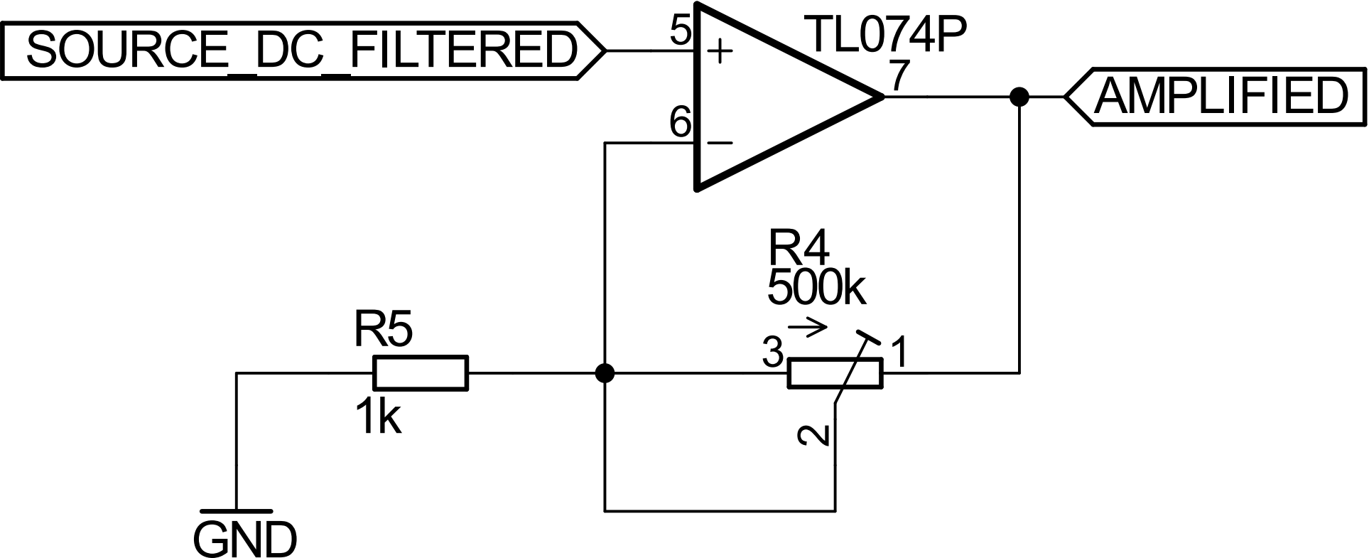
[picture p24: figure]
GND; AMPLIFIED SOURCE_DC_FILTERED
