SeriousD/SemesterProjekt/Projektbericht/gfx/receiver_part.pdf

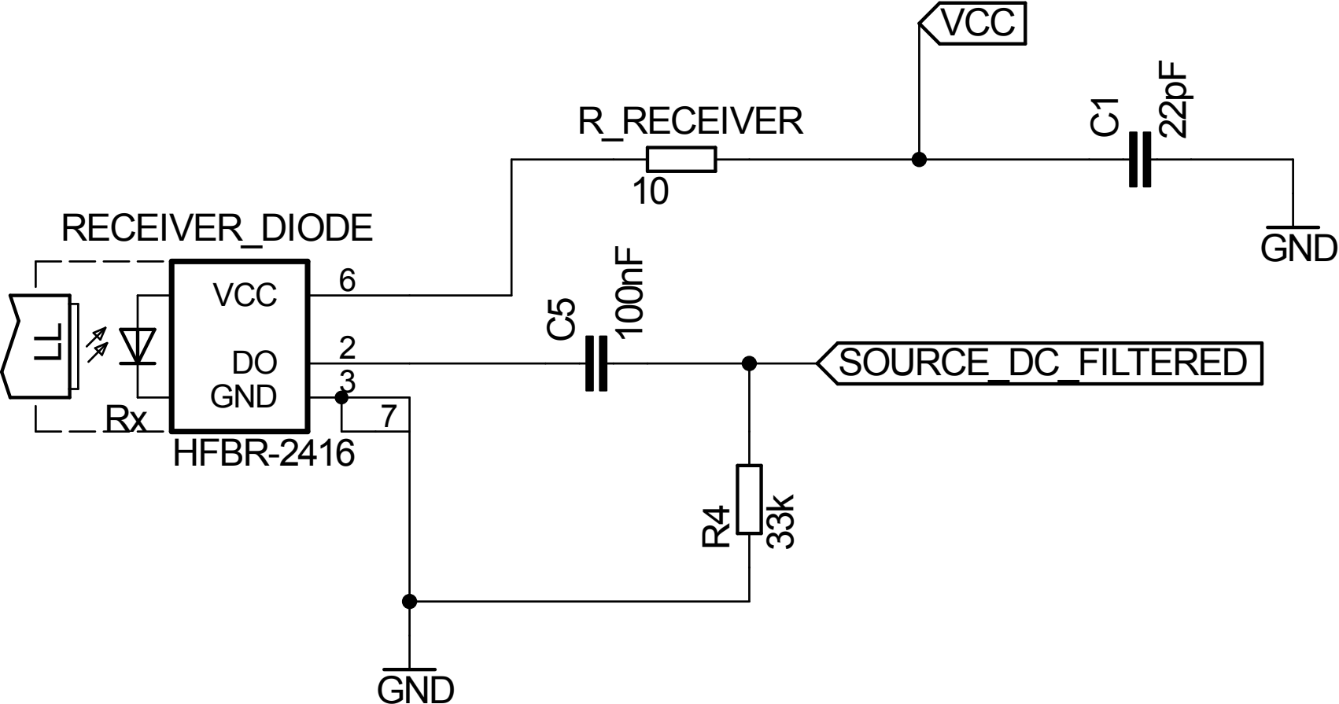
[picture p25: figure]
GND; HFBR-2416; R_RECEIVER R⁴; RECEIVER_DIODE; VCC; SOURCE_DC_FILTERED
