SeriousD/SemesterProjekt/Projektbericht/gfx/vcc.pdf

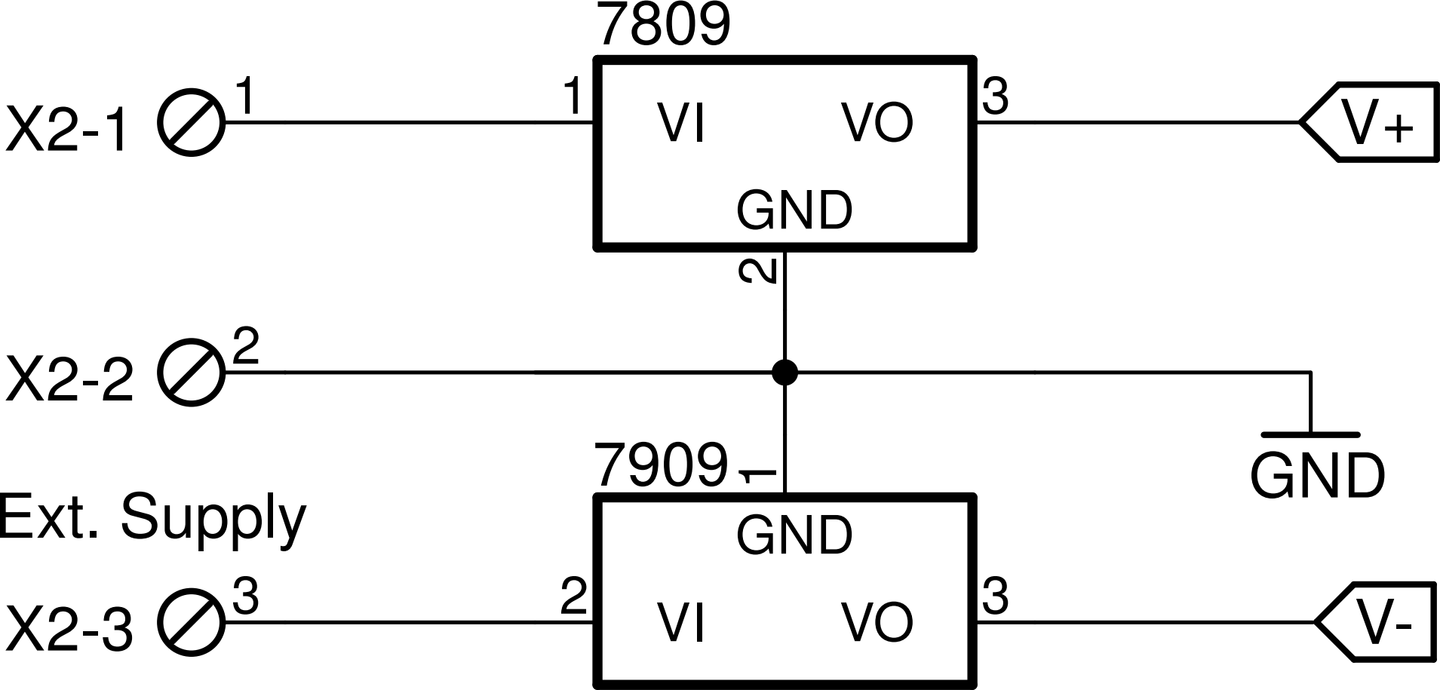
[picture p26: figure]
Ext. Supply; GND
