SeriousD/SemesterProjekt/Projektbericht/justierung.tex

\section{Justierung der Übertragungsstrecke}
\subsection{Rahmenbedingungen}
Zur Justierung der Übertragungsstrecke sind folgende Rahmenbedingungen zu beachten:
\begin{itemize}
\item maximale Eingangsspannung der Sendeeinheit(7V)
\item maximale Ausgangsspannung der Empfangseinheit(5V)
\item Linearität der Modulation
\item Einfacher Umrechnungsfaktor für das gegebene System
\end{itemize}

\subsection{Berechnung des Innenwiderstandes}
Es besteht die Möglichkleit die Impedanz der Sendeeinheit mittels Kippschalter umzuschalten. In der ersten Schalterstellung kann eine Impedanz von 0 bis $10k\Omega$ vorgegeben werden, in der zweiten eine Impedanz von 0 bis $50k\Omega$. Diese werden mittels Trimmpotentiometers eingestellt. 
\subsection{Messergebnisse}
Wie in Abb. \ref{fig:9k89} zu sehen ist, verhält sich der Aufbau über den gesamten 100kV Messbereich linear. Die Funktion der dargestellten Regressionsgeraden lautet:
\begin{equation}
y_i = 50,387569655 \cdot x_i - 0,97547594819
\label{math:regress100kV}
\end{equation} 
  	\begin{figure}[H]
  	\begin{center}
  	
  	\caption{Messwerte mit Regressionsgeraden($9,89k \Omega$ Impedanz)\label{fig:9k89}}
		\input{gfx/just/9k89.pgf}
		\end{center}
	\end{figure}
	Der Widerstand wurde für einen Umrechnungsfaktor von 50000 auf $9,89k\Omega$ eingestellt.
	\begin{figure}[H]
	\input{gfx/just/9k89_TexTable.tex}
	\end{figure}

Auch in Abb. \ref{fig:2k97} ist zu sehen, dass sich der Aufbau über den gesamten 30kV Messbereich linear verhält. Die Funktion der dargestellten Regressionsgeraden lautet:
	\begin{equation}
	y_i = 15,1468815033 \cdot x_i - 0,348516015902
	\label{math:regress30kV}
	\end{equation} 
	\begin{figure}[H]
	\caption{Messwerte mit Regressionsgeraden\label{fig:2k97}}
		\input{gfx/just/2k97.pgf}		
		\end{figure}
				Der Widerstand wurde für einen Umrechnungsfaktor von 15000 auf $2,97k\Omega$ eingestellt.
		\begin{figure}[H]
	\input{gfx/just/2k97_TexTable.tex}
	\end{figure}

\subsection{Qualität der Regressionsgeraden}
\begin{figure}[!htbp]
\centering
 %\includegraphics[scale=1]{gfx/30kV_Messung.pdf}
 %\caption{krasse python grafik}
	%\label{sexy} 
\end{figure}
Die ermittelten Regressionsgeraden für die 30kV Messung und die 100kV Messung, zur Linearitätsuntersuchung der Gesamtschaltung, wurden auf ihre Aussagekraft hin untersucht. Anhand des Bestimmtheitsmaßes lässt sich ausdrücken wie gut die Regressionsgeraden für den gewählten Zusammenhang passen. Hat es den Wert 1 stimmt das Regressionsmodell exakt überein, ist es hingegen 0 besteht kein Zusammenhang für das gewählte Regressionsmodell mit den Messwerten.

Das Bestimmtheitsmaß errechnet sich wie folgt: 
\begin{equation}
R^{2} = 1 - \frac{\sum \limits_{i=1}^n (y_i - \hat{y_i})^{2}}{\sum \limits_{i=1}^n (y_i - \bar{y})^{2}}
\end{equation}
wobei:
\begin{align*}
y_i &= \text{y-Werte der Messung}\\
\hat{y}_i &= \text{y-Werte des Regeressionsmodells (siehe Formel \ref{math:regress100kV} bzw. \ref{math:regress30kV})}\\
\bar{y} &= \text{Mittelwert der y-Werte}
\end{align*}

\subsection{30kV Messung}

\begin{equation}
R^{2} = 1 - \frac{\sum \limits_{i=1}^n (y_i - \hat{y_i})^{2}}{\sum \limits_{i=1}^n (y_i - \bar{y})^{2}} = 1 - \frac{0,1322879878}{2215,9923817778} = 0,999940303
\label{math:30kV_result}
\end{equation}

\begin{table}[H]
  \caption{ Regressionsmodelle für $2,97 \Omega$ Impedanz}
  \begingroup
 
\renewcommand{\arraystretch}{1.5} % Default value: 1
   \begin{tabular}{|c|c|c|}
   \hline
      & Steigung nach Modell & Steigung gerundet     \\
      \hline
    Ordinate nach Modell      & $0,9996982458$      & $0,9991921769$ \\
     \hline
    Ordinate im Ursprung      & $0,9998828785$      & $0,9998436788$ \\
 \hline
  \end{tabular}
  \endgroup
\end{table}

Das Ergebnis der Berechnung aus Formel \ref{math:30kV_result} für die Regressionsgerade bedeutet, dass das Modell zu $99,99\%$ zutrifft. Der Umrechnungsfaktor von 15000 hat dementsprechend einen zu vernachlässigenden Fehler von $0,01\%$.

\subsection{100kV Messung}

\begin{equation}
R^{2} = 1 - \frac{\sum \limits_{i=1}^n (y_i - \hat{y_i})^{2}}{\sum \limits_{i=1}^n (y_i - \bar{y})^{2}} = 1 - \frac{2,7174645603}{10679,9212545455} = 0,9997455539
\label{math:100kV_result}
\end{equation}

\begin{table}[H]
  \caption{ Regressionsmodelle für $9,89 \Omega$ Impedanz}
  \begingroup
\renewcommand{\arraystretch}{1.5} % Default value: 1
   \begin{tabular}{|c|c|c|}
   \hline
      & Steigung nach Modell & Steigung gerundet     \\
      \hline
    Ordinate nach Modell      & $0,9997501434$   & $0,9995324211$ \\
     \hline
    Ordinate im Ursprung      & $0,9987877496$     &$0,9993539593$ \\
 \hline
  \end{tabular}
  \endgroup
\end{table}

Das Ergebnis für die 100kV Berechnung aus Formel \ref{math:100kV_result} trifft für die Regressionsgerade zu $99,97\%$ zu. Der Umrechnungsfaktor von 50000 hat dementsprechend einen ebenfalls zu vernachlässigenden Fehler von $0,03\%$.
