SeriousD/SemesterProjekt/Projektbericht/appendix.tex

\section{Anhang}
\begin{figure}[H]
	\centering
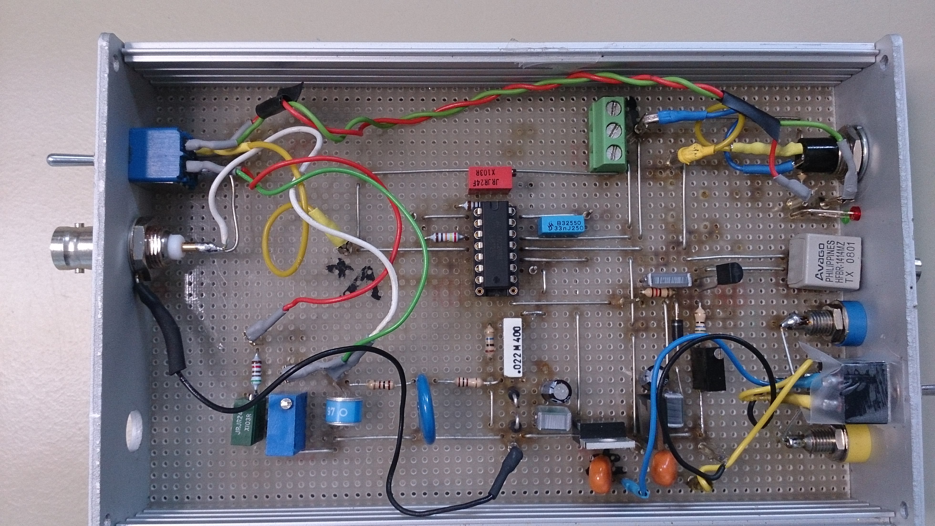
[picture p27: Projektbericht/gfx/inside/tx.JPG]
	
	\caption{Aufbau Sendeeinheit}
\end{figure}

\begin{figure}[H]
	\centering
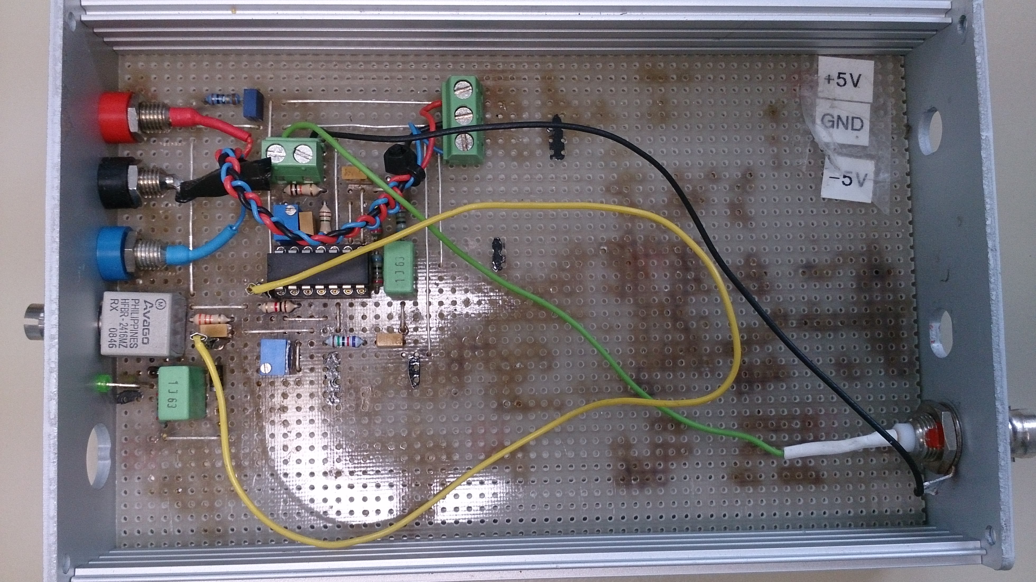
[picture p28: Projektbericht/gfx/inside/rx.JPG]
	
	\caption{Aufbau Empfangseinheit}
\end{figure}

\includepdf[pages=1,angle=90]{gfx/TxSchematic.pdf}
\includepdf[pages=1,angle=90]{gfx/RxSchematic.pdf}
