SeriousD/SemesterProjekt/Projektbericht/einleitung.tex

\section{Einleitung}
Im Hochspannungslabor des Fachbereichs Informatik und Elektrotechnik werden die Messsignale aus dem zum elektrischen Schutz aufgebauten Hochspannungskäfig per BNC Leitung nach außen an die Messgeräte geführt. 
Die Messgeräte und insbesondere die zuführenden Leitungen haben keinen Berührungsschutz, was unmittelbar ein Gefahrenpotential für die Experimentatoren durch Überschläge in die Messleitung birgt.\\
Aufgrund dieser Gefahr soll eine optische Signalsübertragungsstrecke mit einem 
Lichtwellenleiter realisiert werden.\\
Zur Verfügung stehen dazu Hochgeschwindigkeitssende- und Empfangsdioden von des Herstellers Avago (HFBR1414 und HFBR2416).
