SeriousD/SemesterProjekt/Projektbericht/gfx/impedanz.pdf

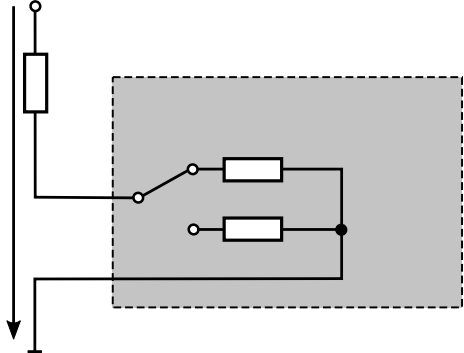
[picture p29: figure]
