SeriousD/SemesterProjekt/Projektbericht/gfx/just/2k97_Preview.pdf

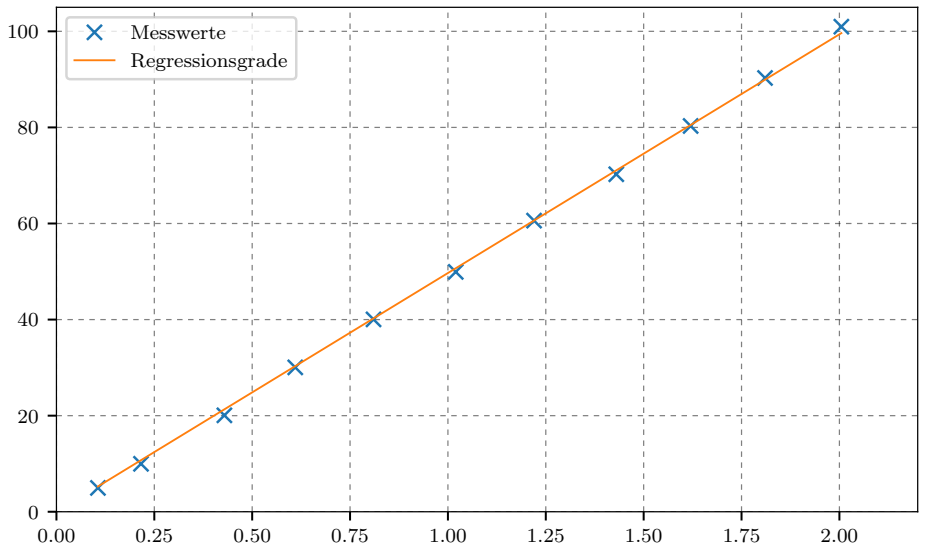
[picture p30: figure]
Messwerte; Regressionsgrade

U1/V

U2/V
