SeriousD/SemesterProjekt/Projektbericht/gfx/just/9k89_Preview.pdf

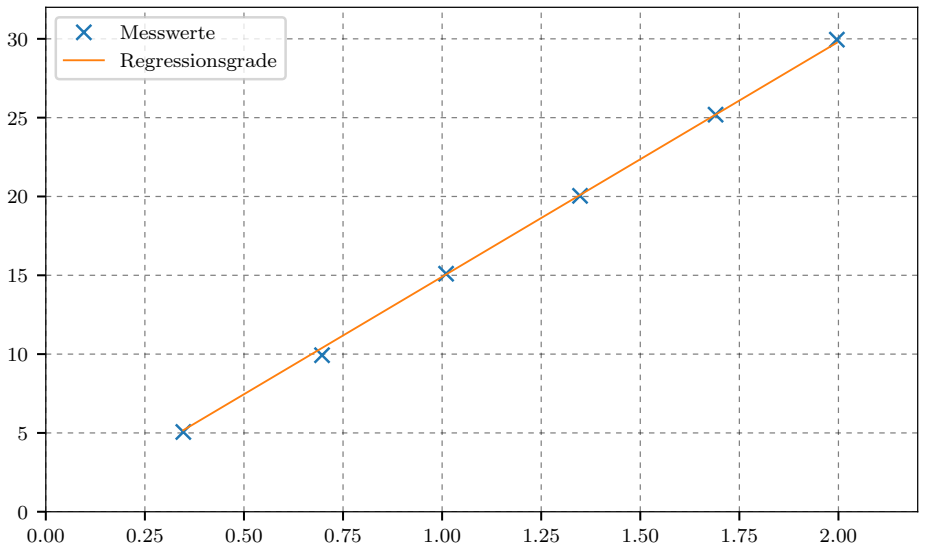
[picture p31: figure]
Messwerte; Regressionsgrade

U1/V

U2/V
