SeriousD/SemesterProjekt/Projektbericht/gfx/just/Alle_Rechnungen.ods

30kV_Regressionsgerade |  |  |  |  |  |  | 30kV_Umrechnungsfaktor
x | y | y-y_quer | (Y-Y_quer)² | Y_dach | Y-Y_dach | (Y-Y_dach)² | x | y | y-y_quer | (Y-Y_quer)² | Y_dach | Y-Y_dach | (Y-Y_dach)²
1,996 | 29,95 | 12,405 | 153,884025 | 29,8846594647 | 0,0653405353 | 0,0042693856 | 1,996 | 29,95 | 12,405 | 153,884025 | 29,5914839841 | 0,3585160159 | 0,1285337337
1,69 | 25,19 | 7,645 | 58,446025 | 25,2497137247 | -0,0597137247 | 0,0035657289 | 1,69 | 25,19 | 7,645 | 58,446025 | 25,0014839841 | 0,1885160159 | 0,0355382883
1,348 | 20,04 | 2,495 | 6,225025 | 20,0694802505 | -0,0294802505 | 0,0008690852 | 1,348 | 20,04 | 2,495 | 6,225025 | 19,8714839841 | 0,1685160159 | 0,0283976476
1,01 | 15,1 | -2,445 | 5,978025 | 14,9498343024 | 0,1501656976 | 0,0225497367 | 1,01 | 15,1 | -2,445 | 5,978025 | 14,8014839841 | 0,2985160159 | 0,0891118118
0,697 | 9,93 | -7,615 | 57,988225 | 10,2088603919 | -0,2788603919 | 0,0777631182 | 0,697 | 9,93 | -7,615 | 57,988225 | 10,1064839841 | -0,1764839841 | 0,0311465966
0,347 | 5,06 | -12,485 | 155,875225 | 4,9074518657 | 0,1525481343 | 0,0232709333 | 0,347 | 5,06 | -12,485 | 155,875225 | 4,8564839841 | 0,2035160159 | 0,0414187687
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
