SeriousD/SemesterProjekt/Projektbericht/gfx/just/2k97.csv

U1 | U2
2.005 | 100.97
1.81 | 90.29
1.62 | 80.3
1.43 | 70.25
1.22 | 60.6
1.02 | 49.93
0.81 | 40.04
0.61 | 30.05
0.429 | 20.07
0.216 | 9.98
0.106 | 4.96
