SeriousD/SemesterProjekt/Projektbericht/gfx/just/9k89.csv

U1 | U2
1.996 | 29.95
1.69 | 25.19
1.348 | 20.04
1.01 | 15.1
0.697 | 9.93
0.347 | 5.06
