SeriousD/SemesterProjekt/Projektbericht/gfx/AVAGO_Schaltung.png

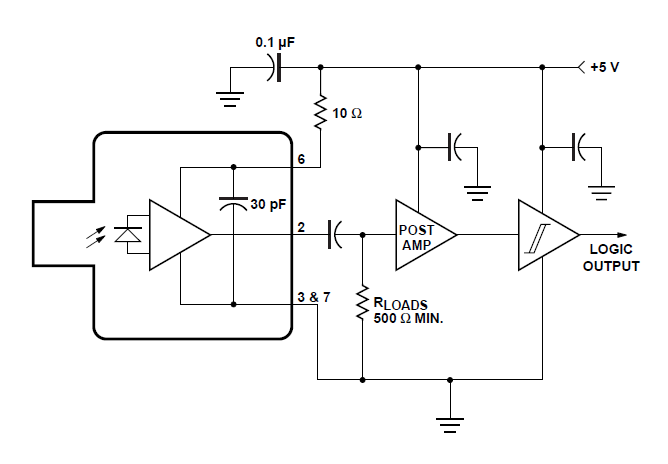
Projektbericht/gfx/AVAGO_Schaltung.png
