SeriousD/SemesterProjekt/Projektbericht/gfx/driver.png

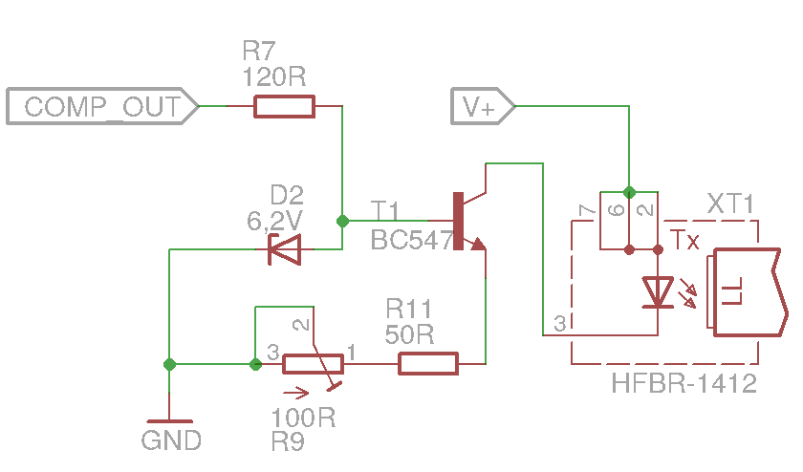
Projektbericht/gfx/driver.png
