SeriousD/SemesterProjekt/Projektbericht/gfx/filtered.png

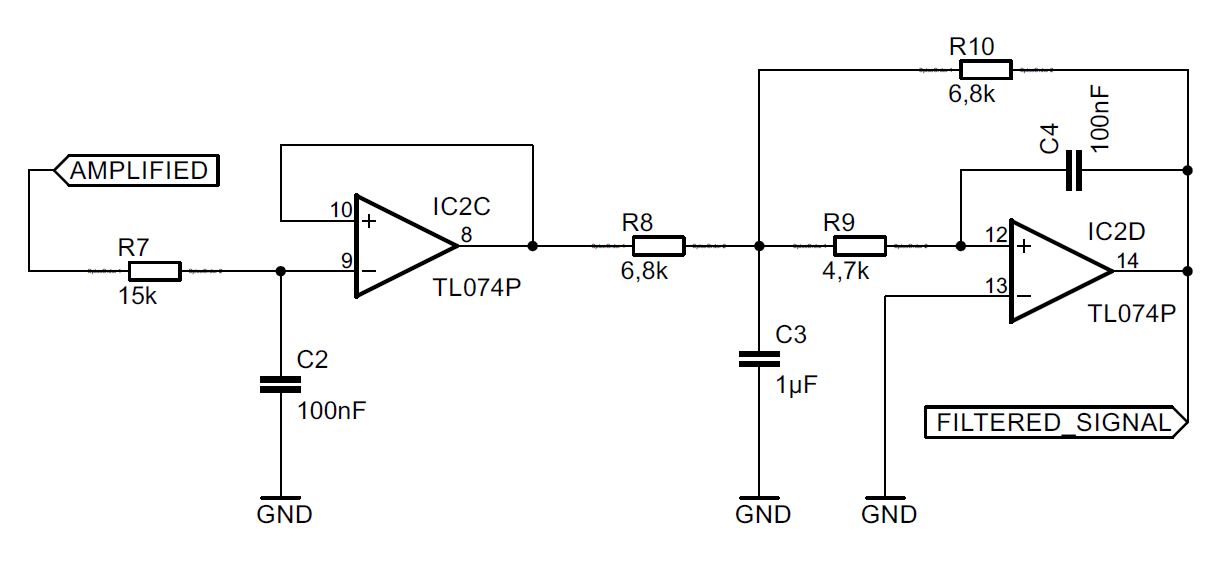
Projektbericht/gfx/filtered.png
