SeriousD/SemesterProjekt/Projektbericht/gfx/FM.png

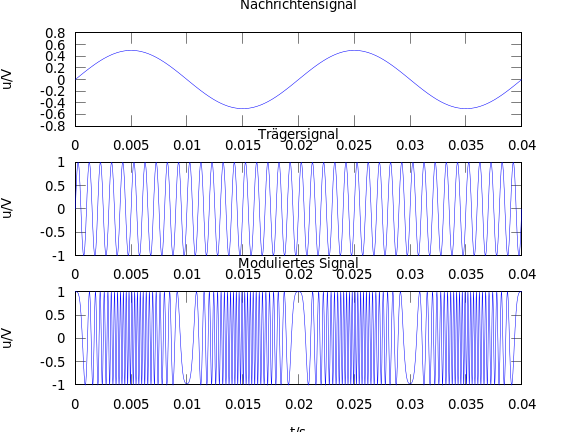
Projektbericht/gfx/FM.png
