SeriousD/SemesterProjekt/Projektbericht/gfx/kaskade.png

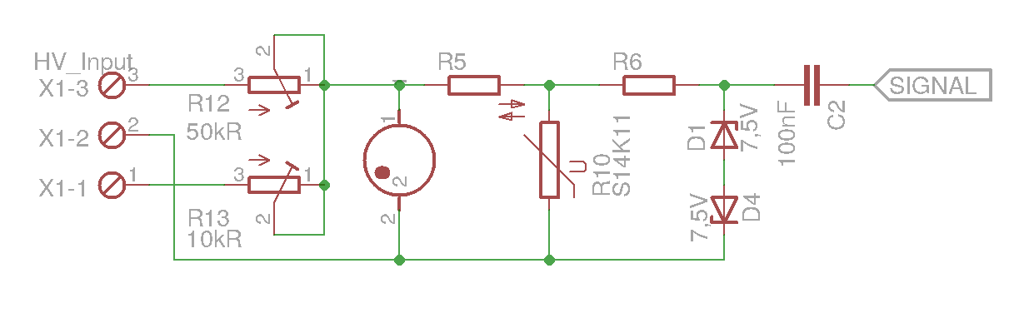
Projektbericht/gfx/kaskade.png
