SeriousD/SemesterProjekt/Projektbericht/gfx/miller_integrator.png

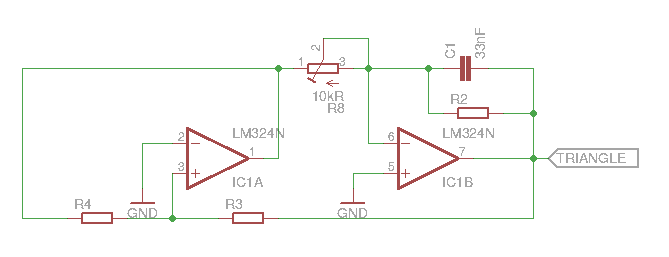
Projektbericht/gfx/miller_integrator.png
