SeriousD/SemesterProjekt/Projektbericht/gfx/modulator.png

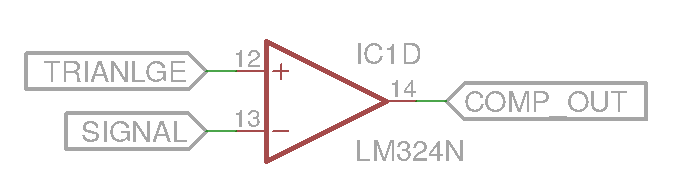
Projektbericht/gfx/modulator.png
