SeriousD/SemesterProjekt/Projektbericht/gfx/osziScreens/scope_5.png

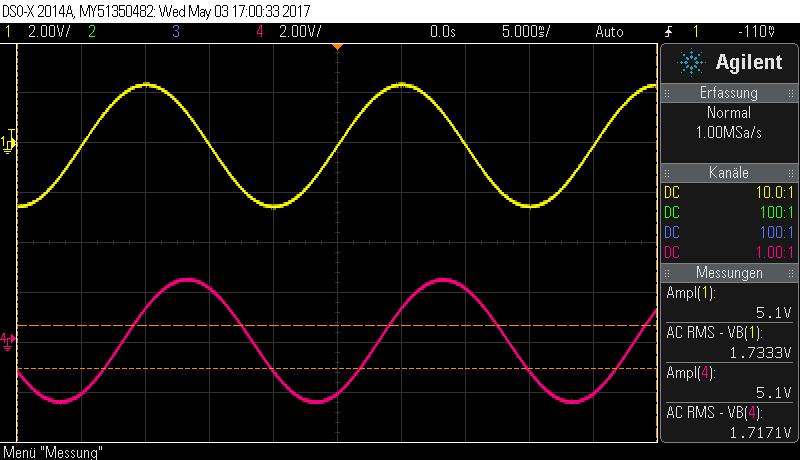
Projektbericht/gfx/osziScreens/scope_5.png
