SeriousD/SemesterProjekt/Projektbericht/gfx/pre_amplifier.png

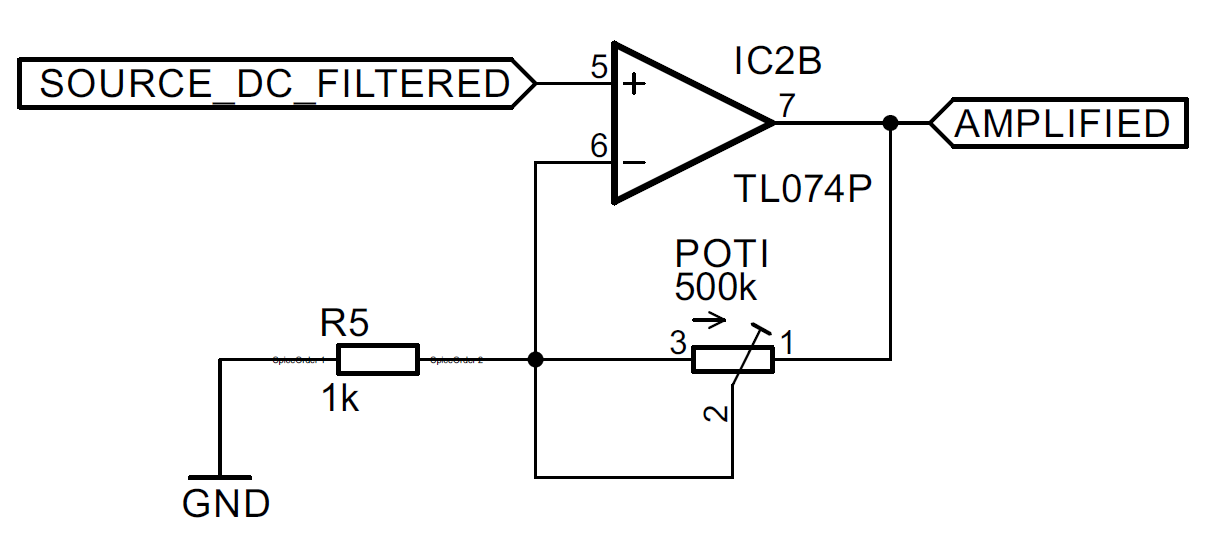
Projektbericht/gfx/pre_amplifier.png
