SeriousD/SemesterProjekt/Projektbericht/gfx/PWM.png

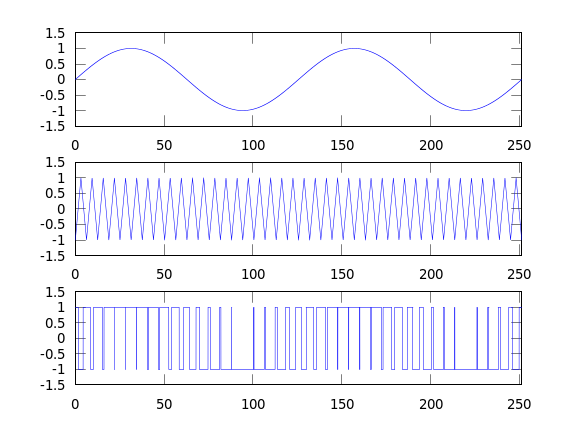
Projektbericht/gfx/PWM.png
