SeriousD/SemesterProjekt/Projektbericht/gfx/receiver_part.png

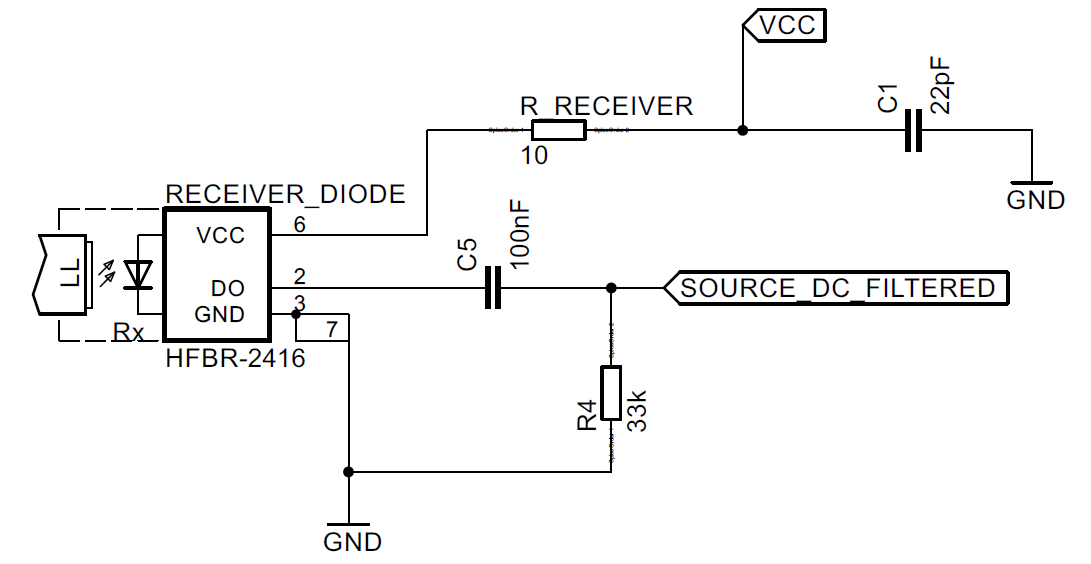
Projektbericht/gfx/receiver_part.png
