SeriousD/SemesterProjekt/Projektbericht/gfx/schaltung.png

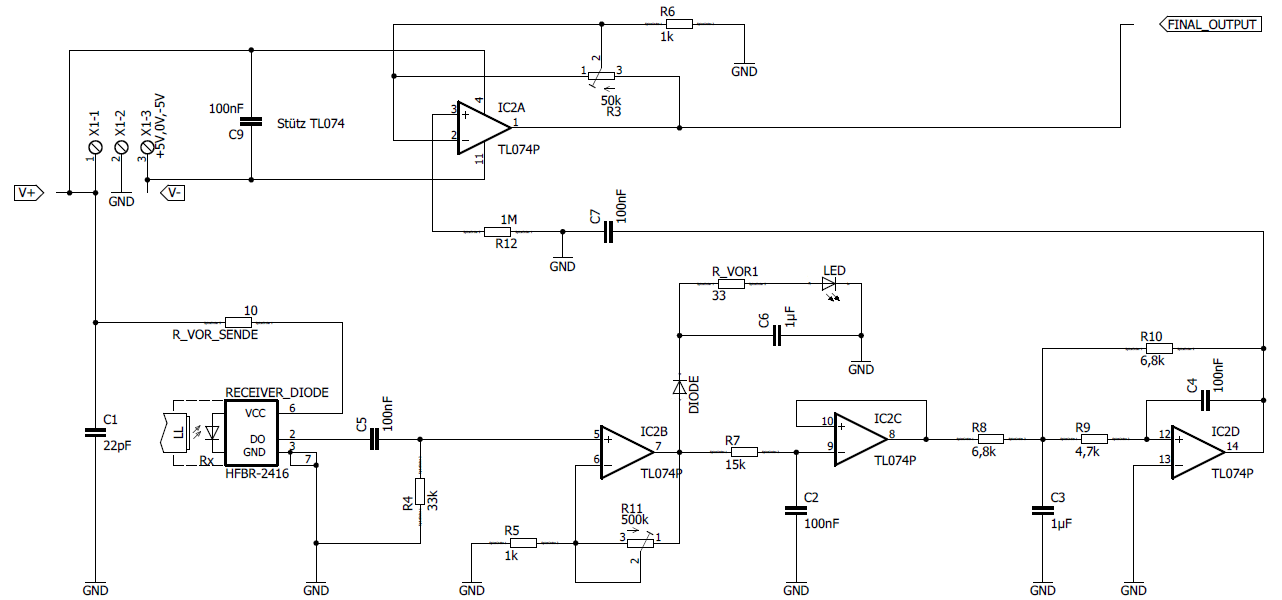
Projektbericht/gfx/schaltung.png
