SeriousD/SemesterProjekt/Projektbericht/gfx/signal3.png

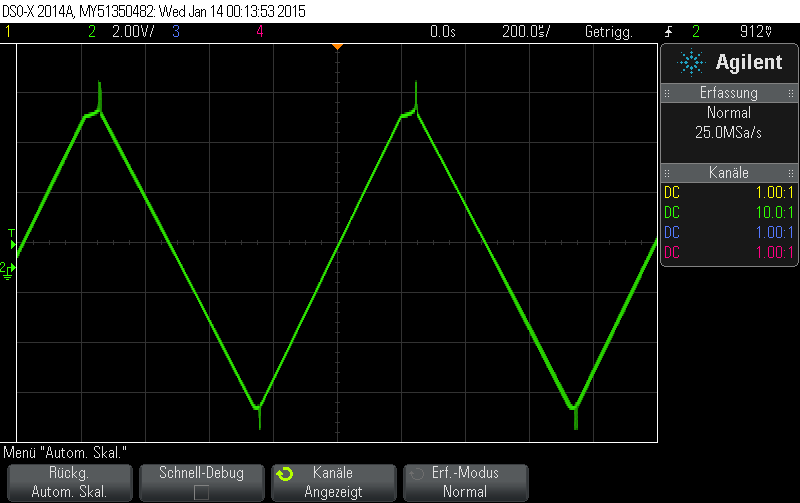
Projektbericht/gfx/signal3.png
