SeriousD/SemesterProjekt/Projektbericht/gfx/signal4.png

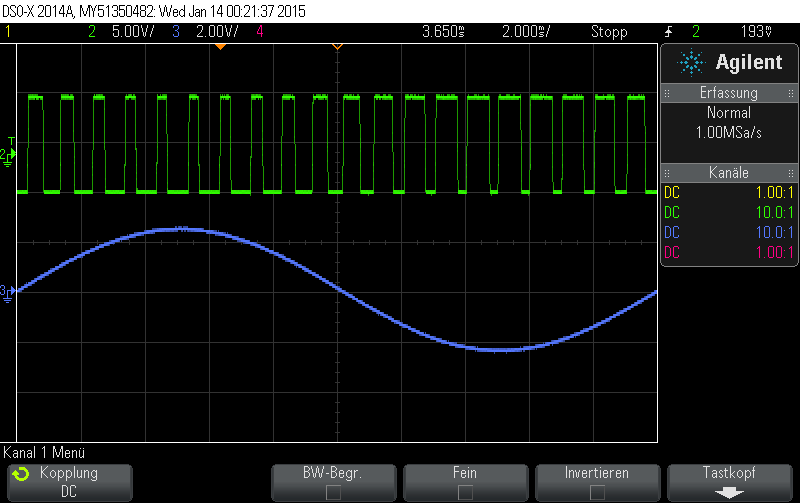
Projektbericht/gfx/signal4.png
