SeriousD/SemesterProjekt/Projektbericht/gfx/signal7.png

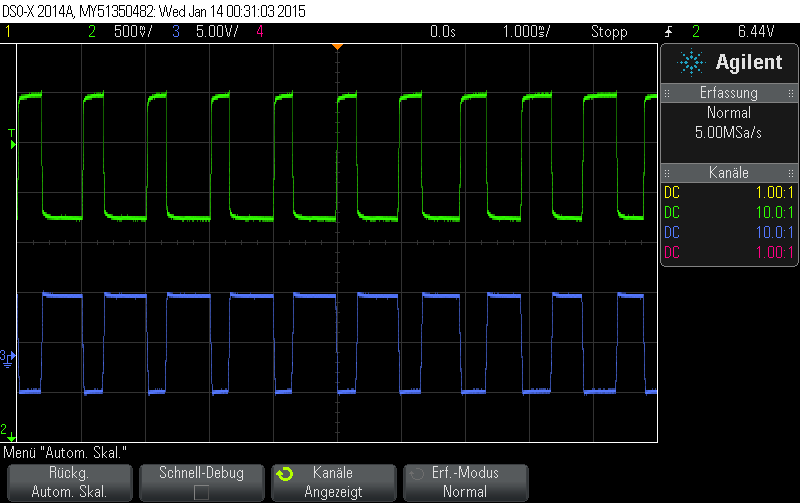
Projektbericht/gfx/signal7.png
