SeriousD/SemesterProjekt/Projektbericht/gfx/signal8.png

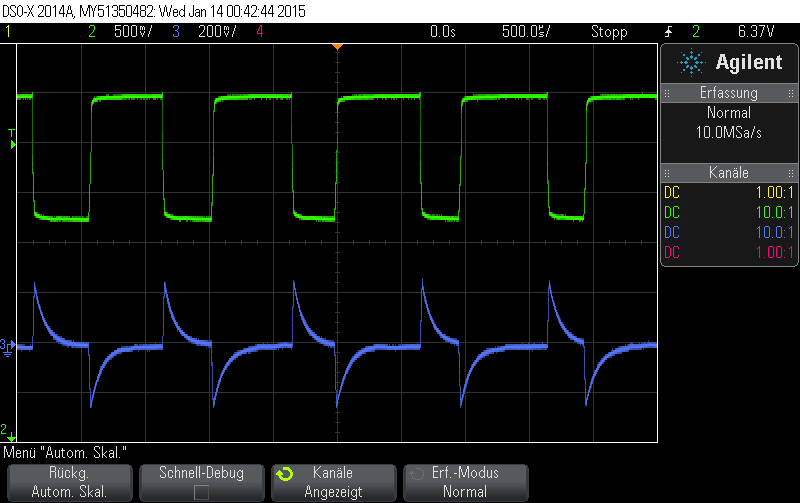
Projektbericht/gfx/signal8.png
