SeriousD/SemesterProjekt/Projektbericht/gfx/signal.png

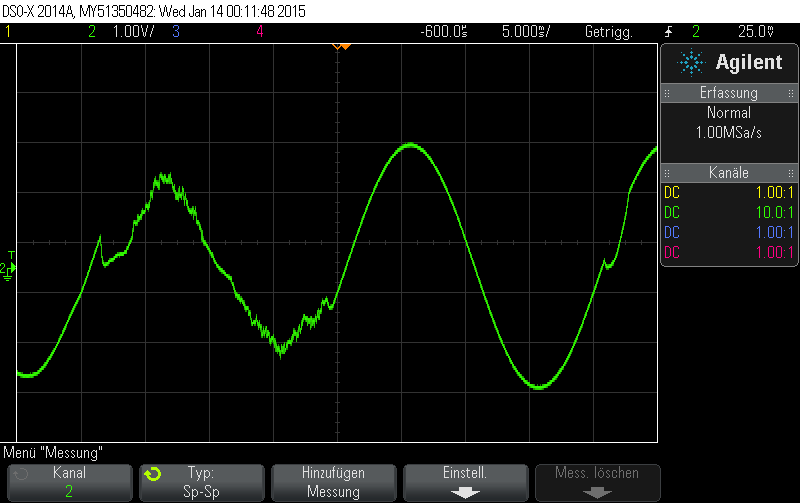
Projektbericht/gfx/signal.png
