SeriousD/SemesterProjekt/Projektbericht/gfx/signaldetektion.png

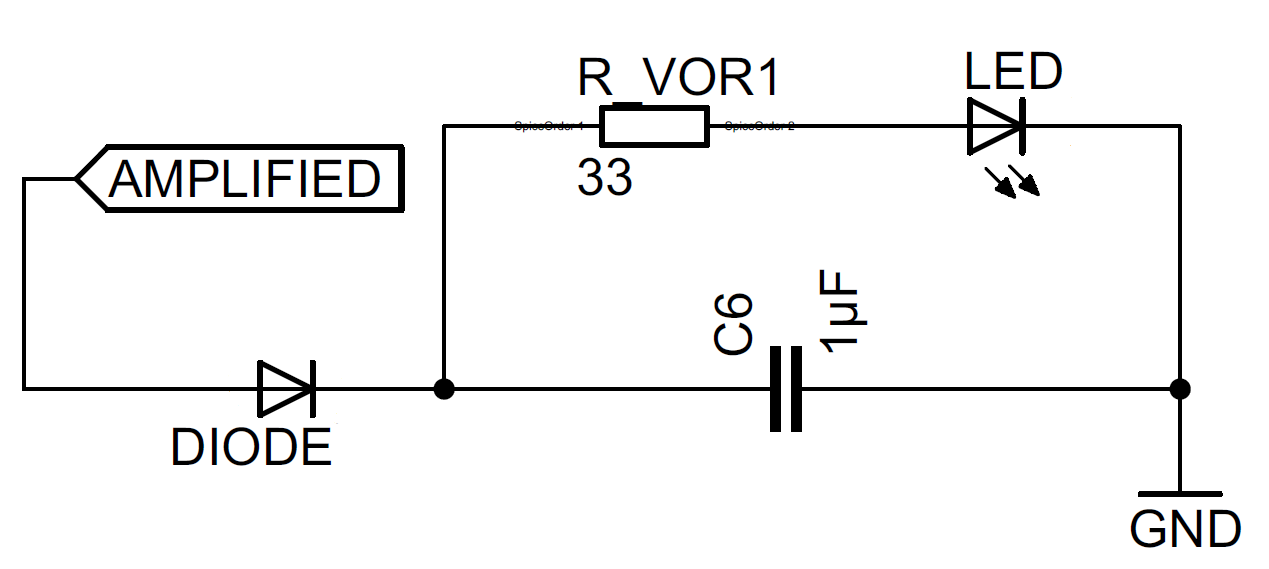
Projektbericht/gfx/signaldetektion.png
