SeriousD/SemesterProjekt/Projektbericht/gfx/simTx/PWMsynthNote.png

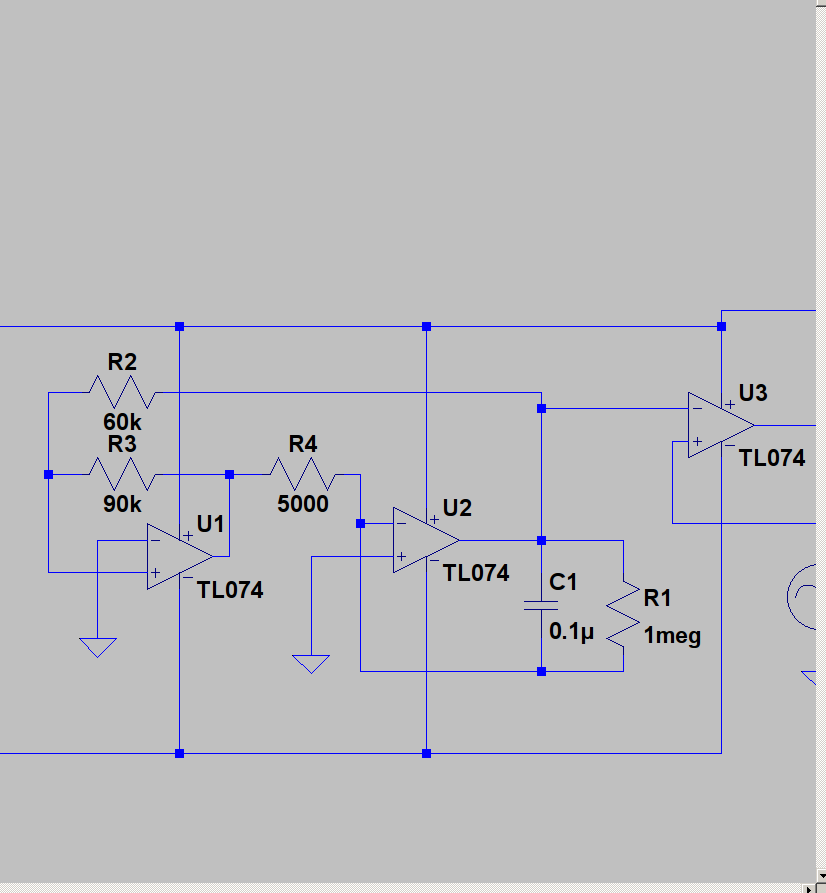
Projektbericht/gfx/simTx/PWMsynthNote.png
