SeriousD/SemesterProjekt/Anleitung/gfx/rx-back.pdf

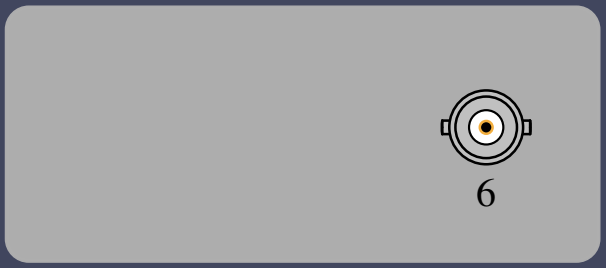
[picture p52: figure]
