SeriousD/SemesterProjekt/Kalibrierung/kalibrierung.pdf

## 1 Test

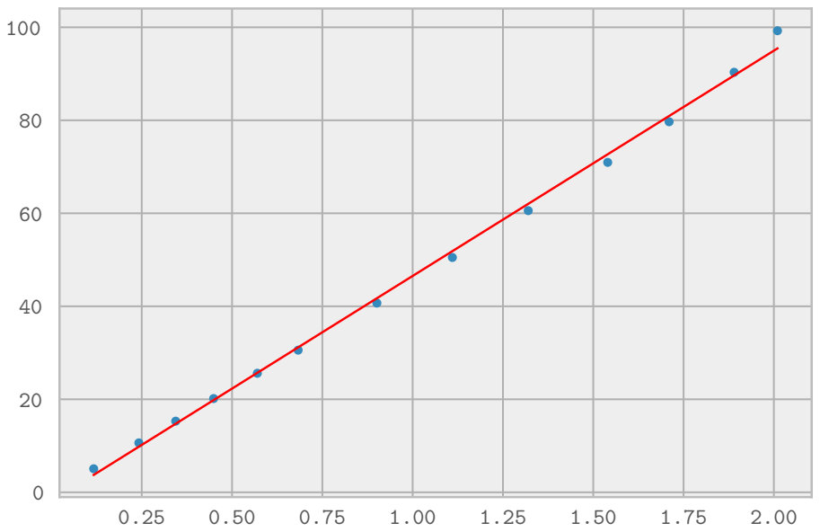
[picture p61: figure]

| U1 | U2
0 | 2.010 | 99.260
1 | 1.890 | 90.330
2 | 1.710 | 79.680
3 | 1.540 | 70.950
4 | 1.320 | 60.570
5 | 1.110 | 50.500
6 | 0.901 | 40.690
7 | 0.683 | 30.570
8 | 0.570 | 25.600
9 | 0.449 | 20.160
10 | 0.344 | 15.300
11 | 0.242 | 10.630
12 | 0.117 | 5.062

1

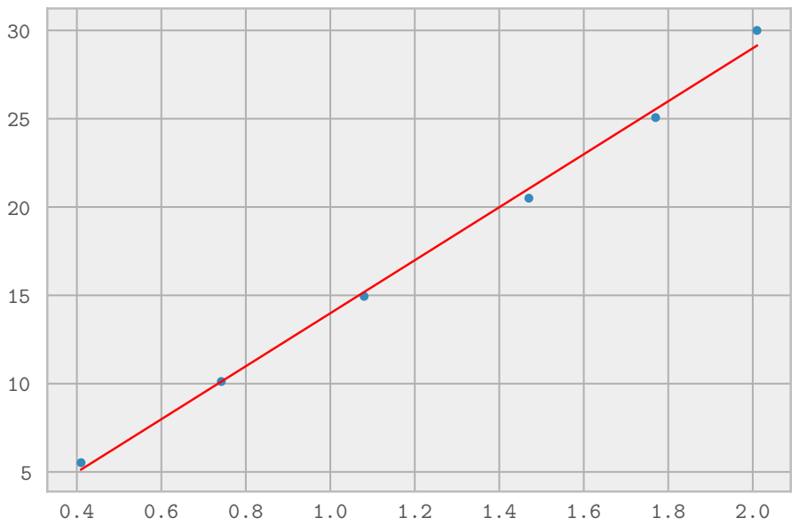
[picture p62: figure]

| U1 | U2
0 | 2.010 | 30.000
1 | 1.770 | 25.066
2 | 1.470 | 20.500
3 | 1.080 | 14.943
4 | 0.742 | 10.122
5 | 0.410 | 5.524

2
