SeriousD/SemesterProjekt/Projektbericht/gfx/RxSchematic.pdf

A

A

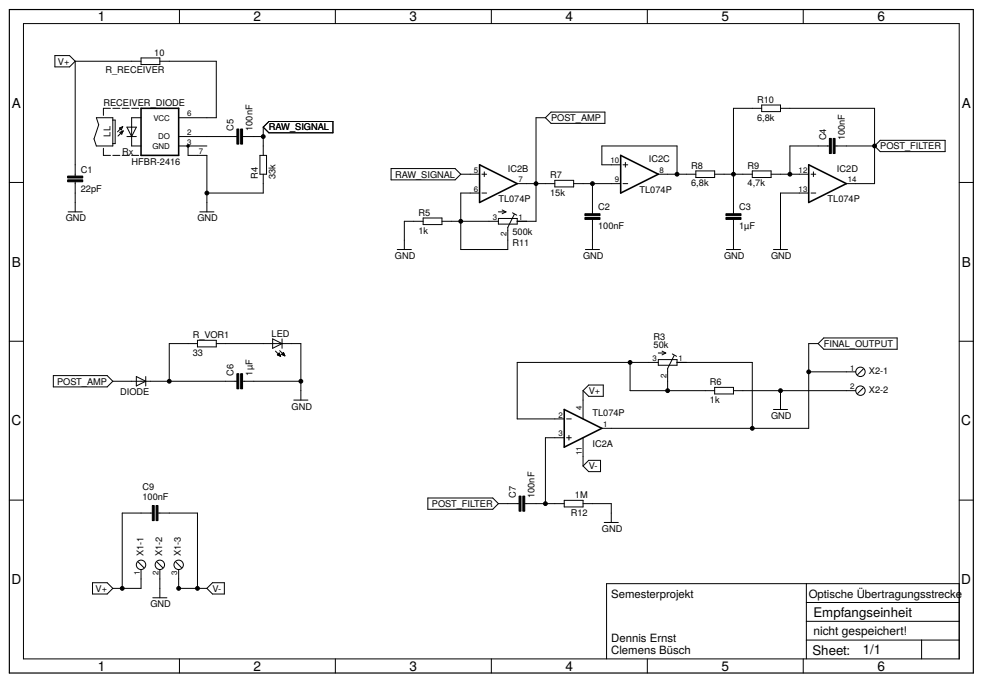
[picture p63: page 1]
