SeriousD/SemesterProjekt/Projektbericht/gfx/TxSchematic.pdf

A

A

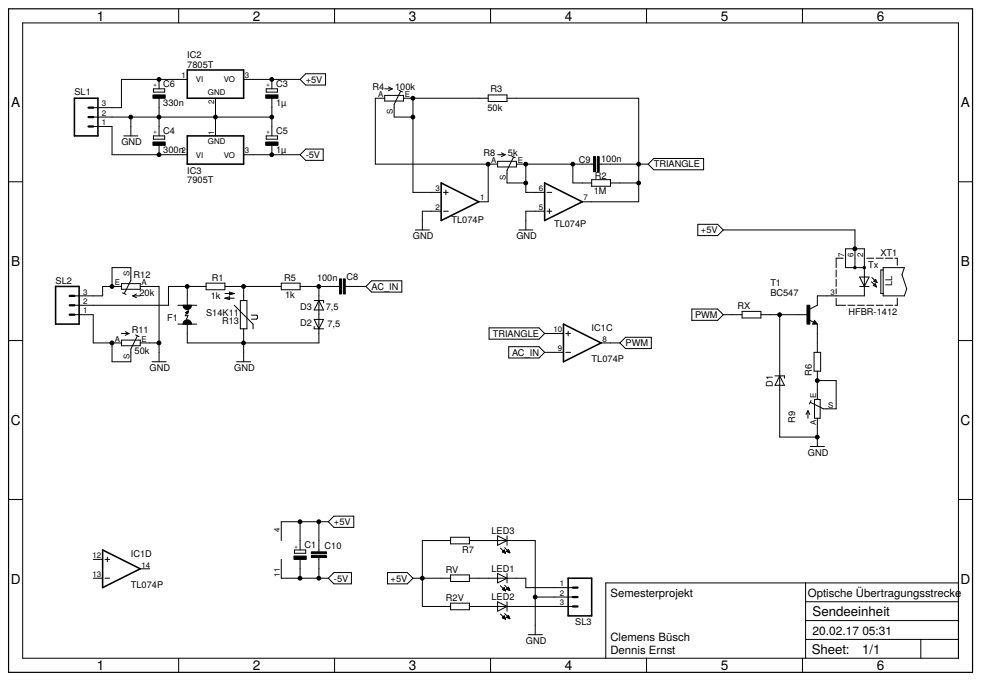
[picture p64: page 1]
