SeriousD/SemesterProjekt/Projektbericht/gfx/eingangstufe.pdf

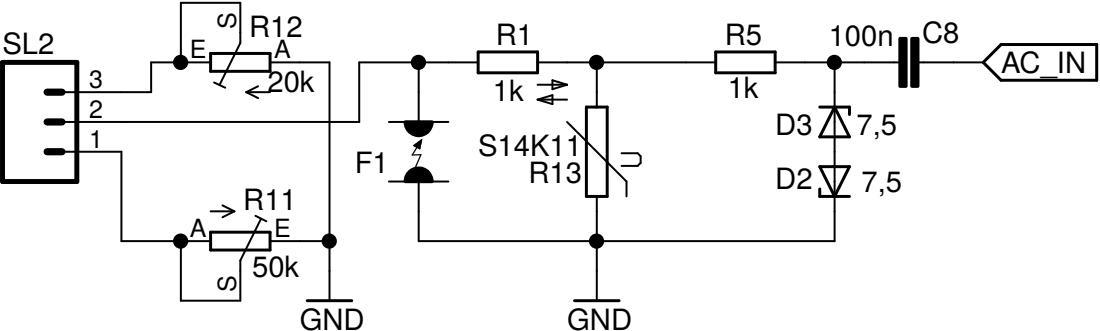
[picture p65: page 1]
