SeriousD/SemesterProjekt/Anleitung/gfx/rx-front.pdf

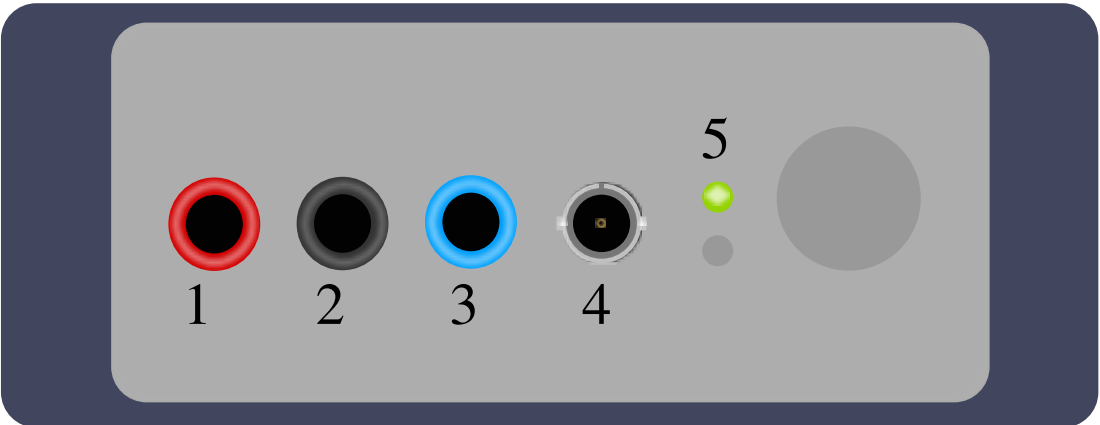
[picture p66: page 1]
