SeriousD/SemesterProjekt/Anleitung/gfx/tx-back.pdf

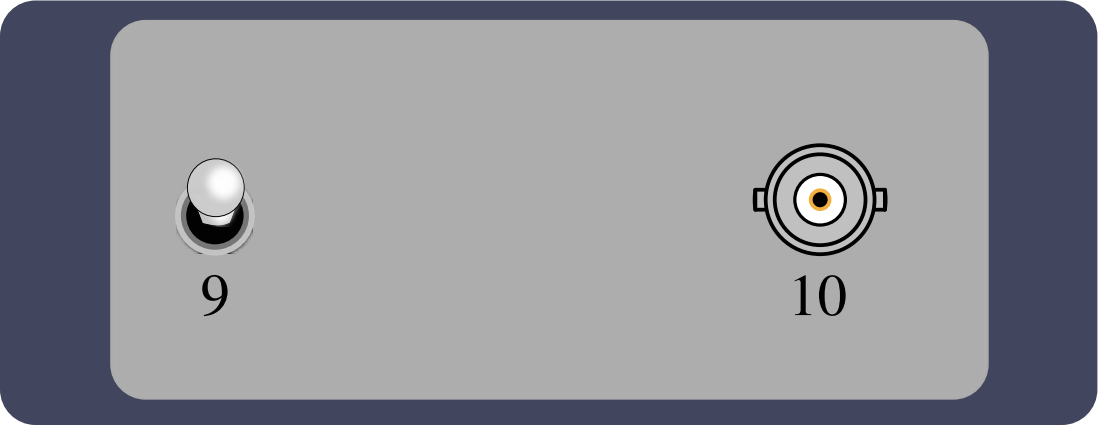
[picture p67: page 1]
