SeriousD/SemesterProjekt/Anleitung/gfx/tx-front.pdf

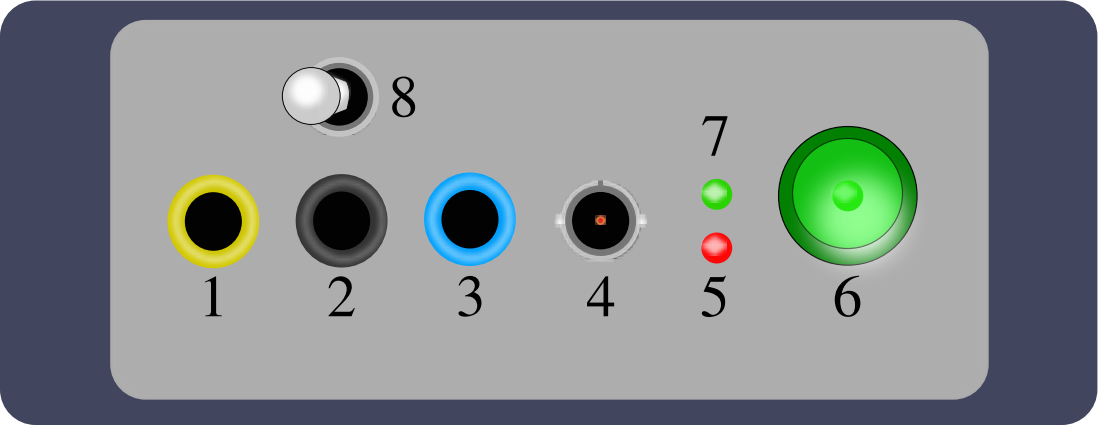
[picture p68: page 1]
