SeriousD/SemesterProjekt/Projektbericht/gfx/eingang.pdf

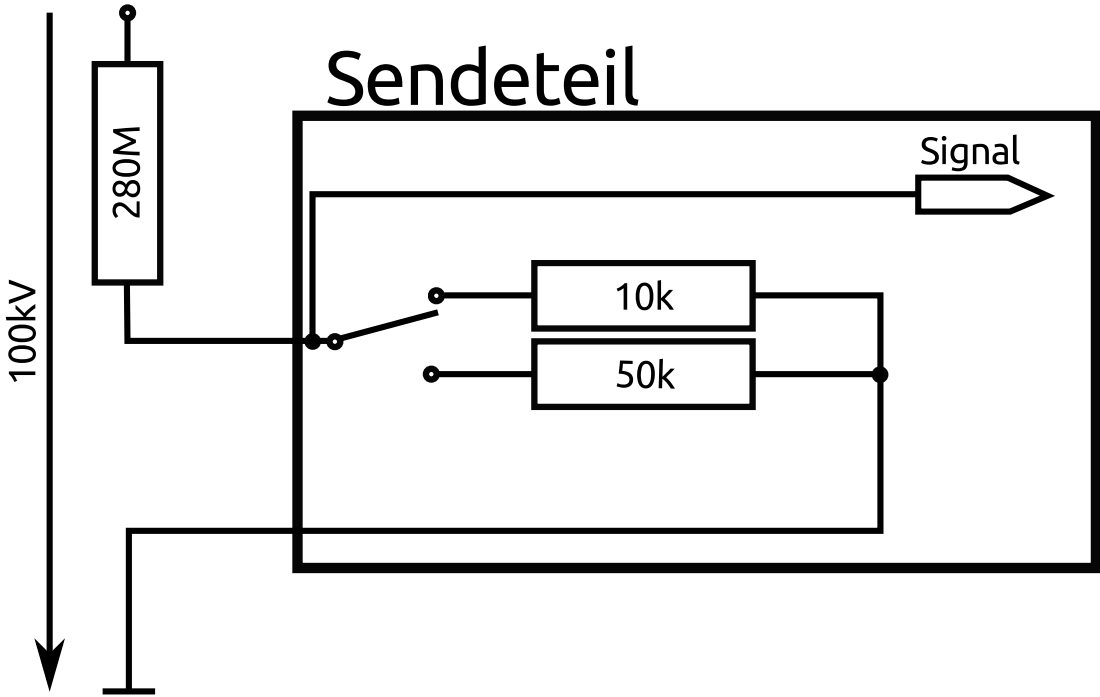
[picture p69: page 1]
