SeriousD/SemesterProjekt/Projektbericht/gfx/filter.pdf

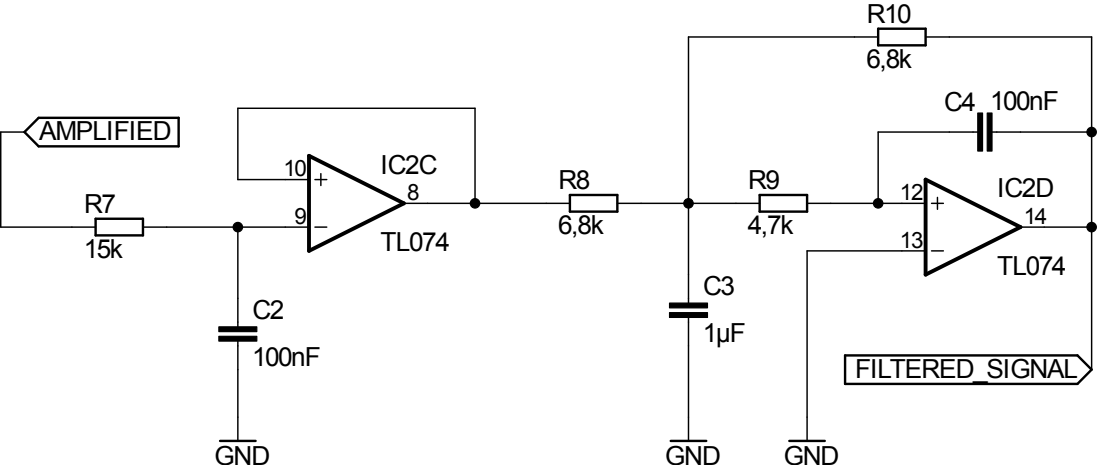
[picture p70: page 1]
