SeriousD/SemesterProjekt/Projektbericht/gfx/filtered.pdf

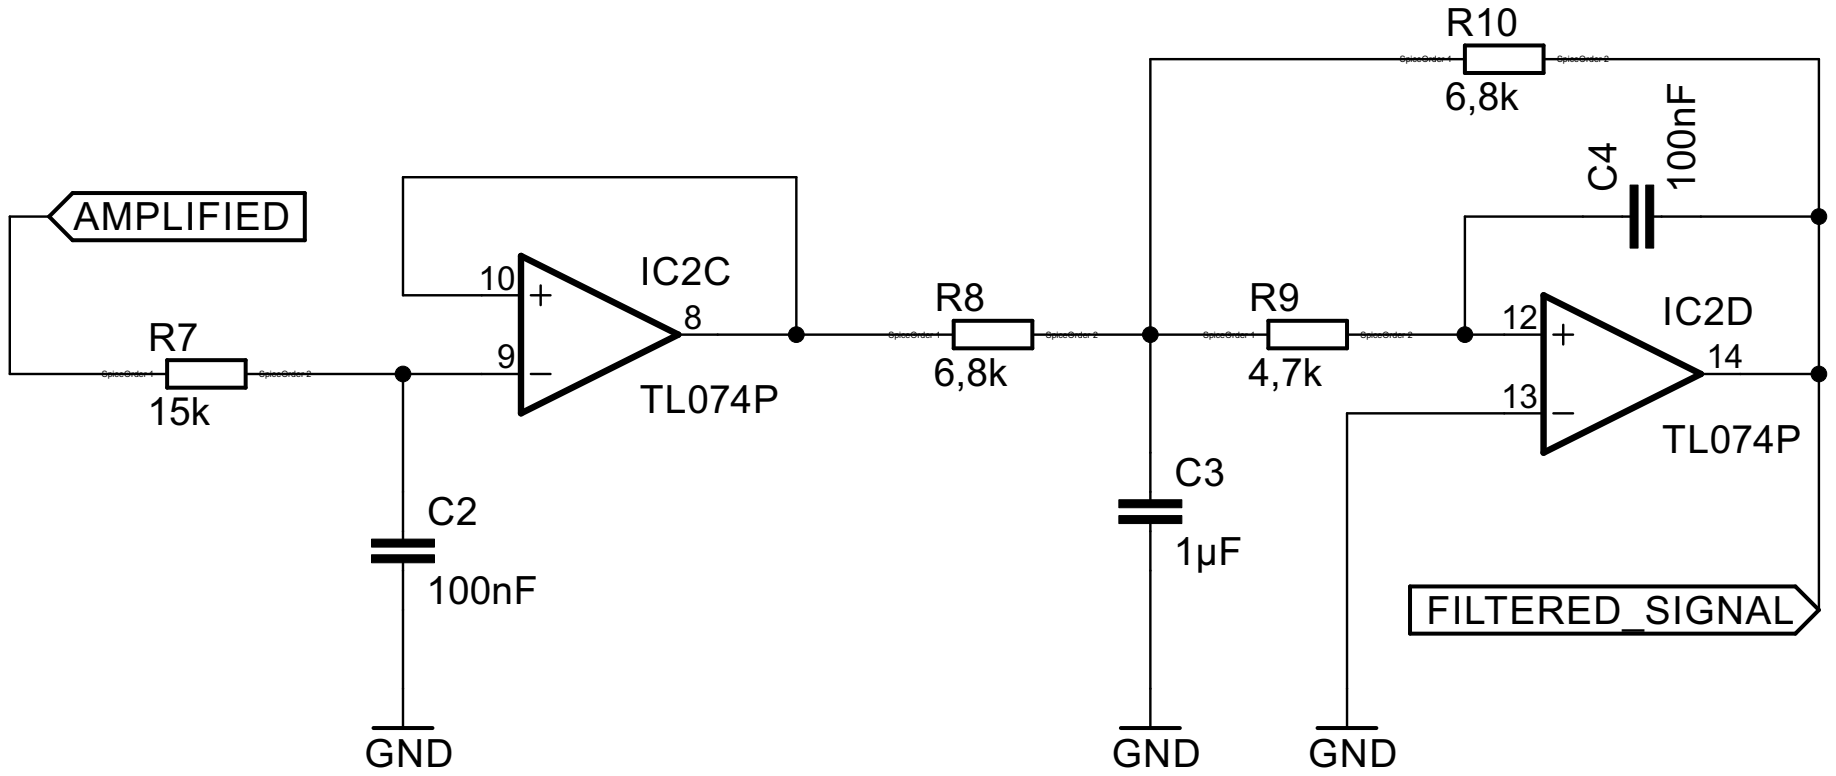
[picture p71: page 1]
