SeriousD/SemesterProjekt/Projektbericht/gfx/hfbr.pdf

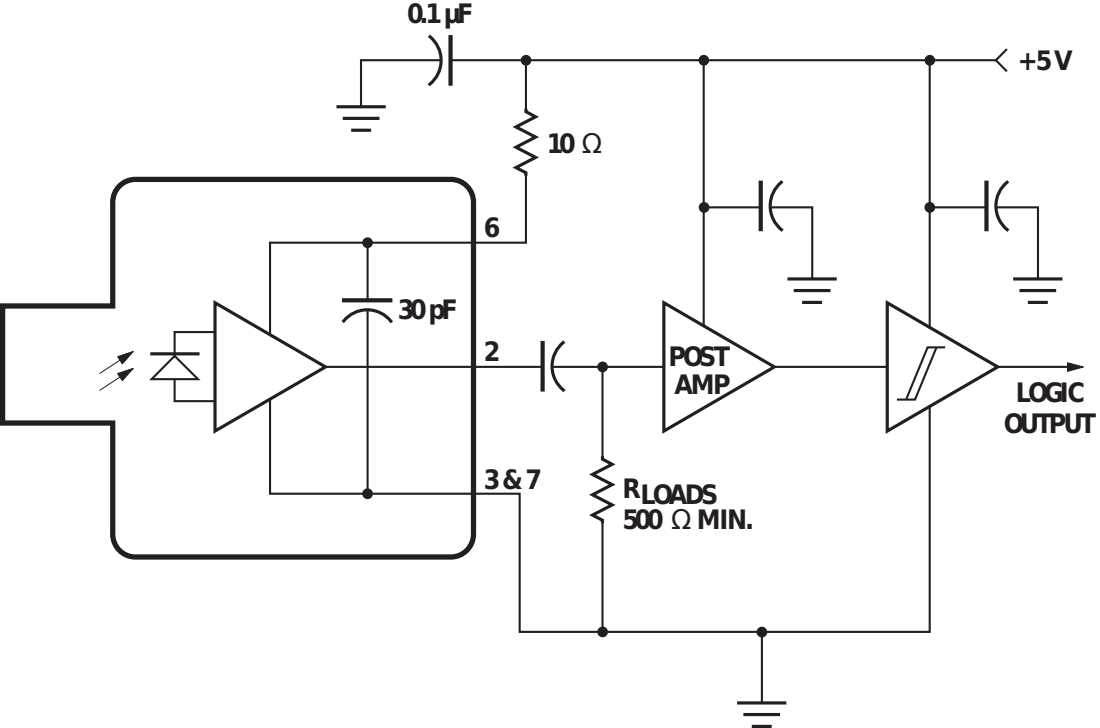
[picture p72: page 1]
LOGIC OUTPUT; RLOADS 500 Ω MIN.; POST AMP
