SeriousD/SemesterProjekt/Projektbericht/gfx/input.pdf

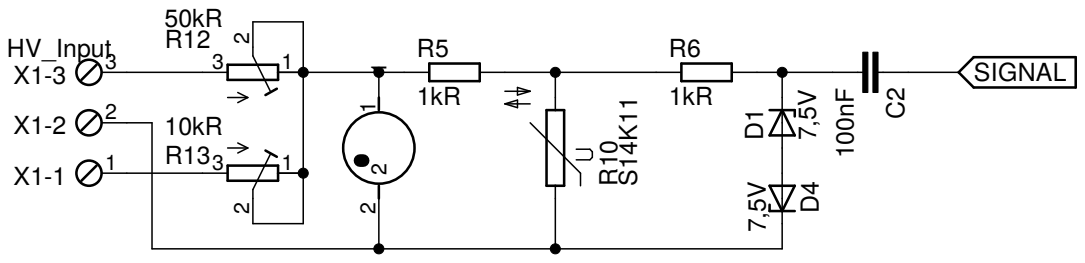
[picture p73: page 1]
