SeriousD/SemesterProjekt/Projektbericht/gfx/pre_amplifier.pdf

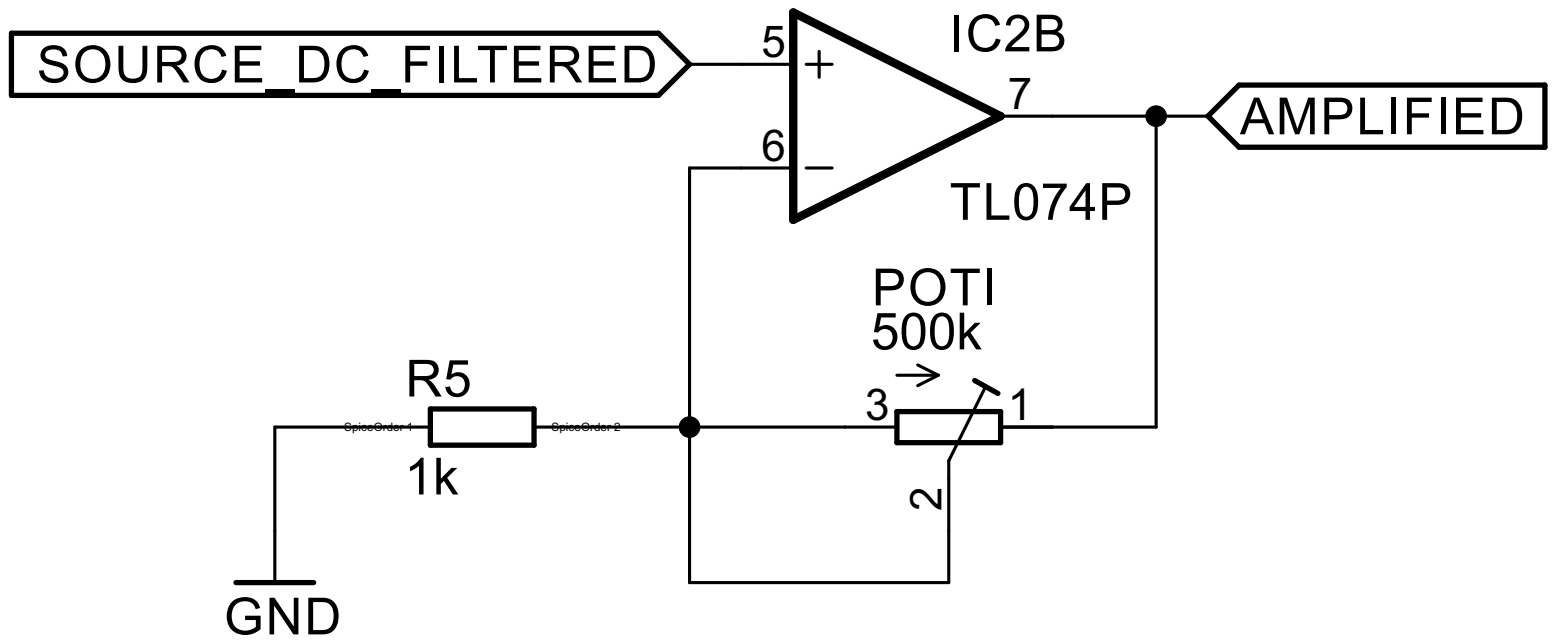
[picture p74: page 1]
