SeriousD/SemesterProjekt/Projektbericht/gfx/Schaltplan.pdf

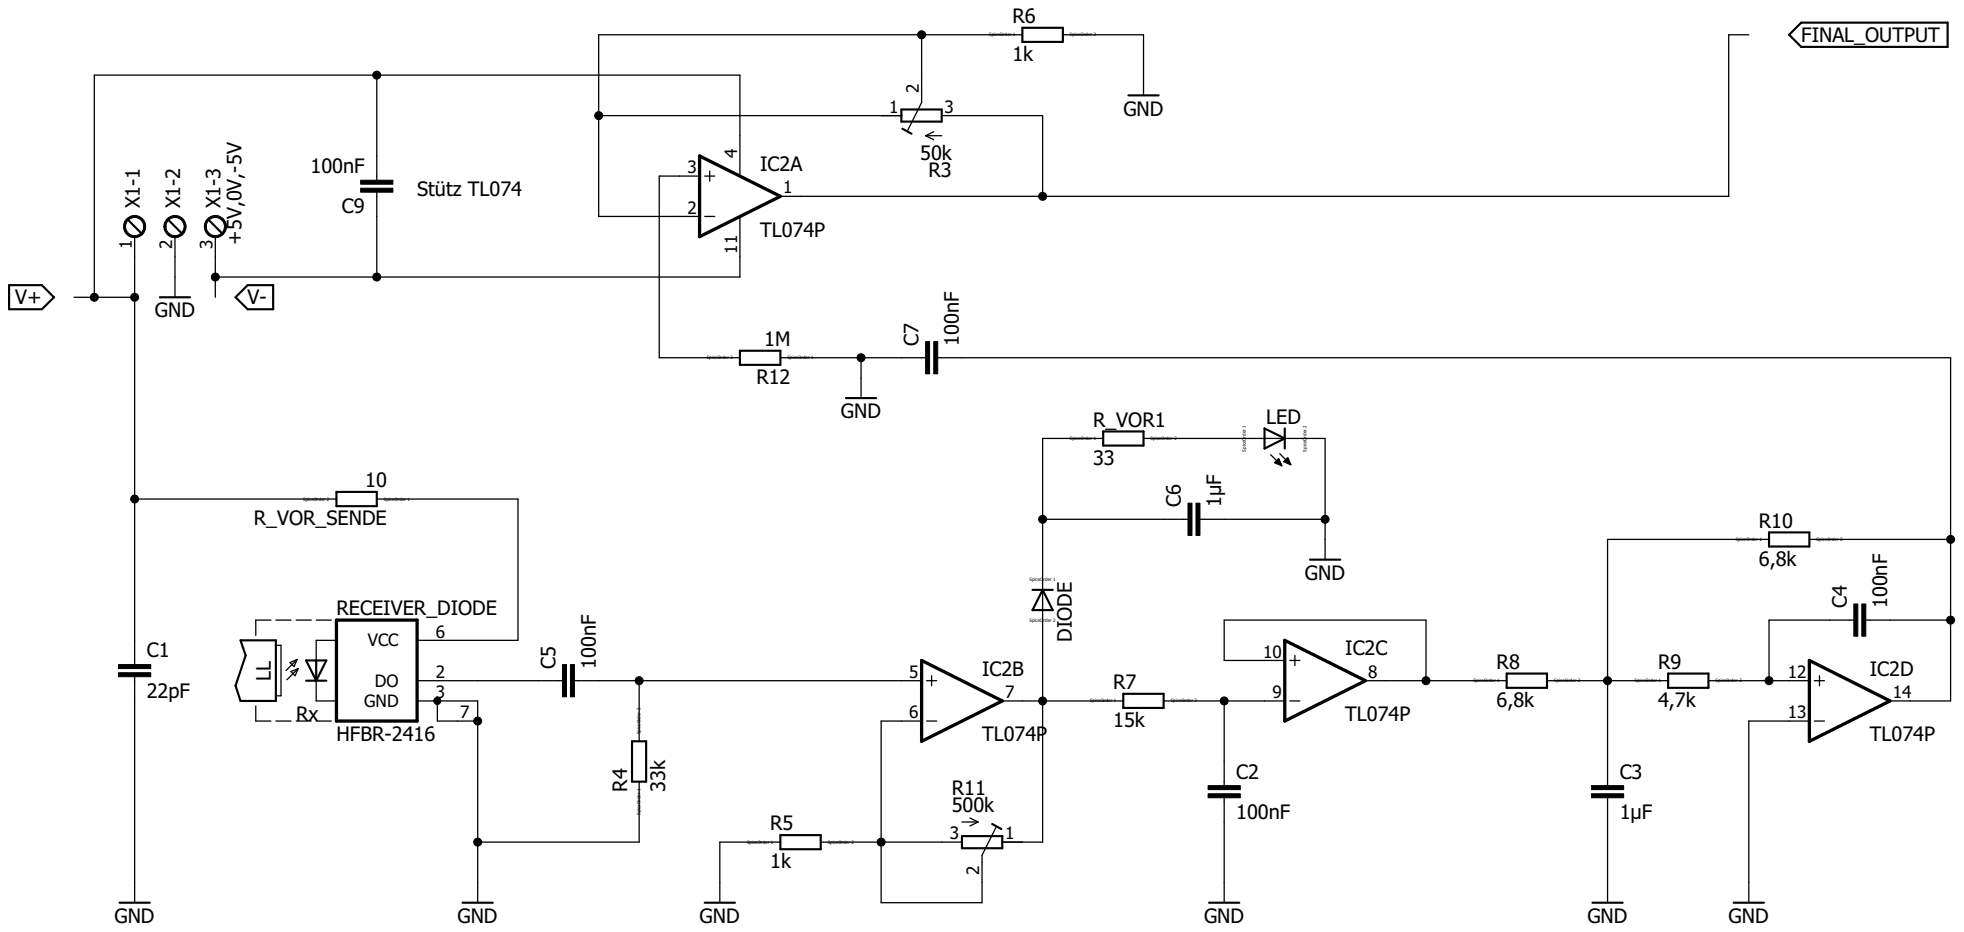
[picture p75: page 1]
