SeriousD/SemesterProjekt/Projektbericht/gfx/struktur.pdf

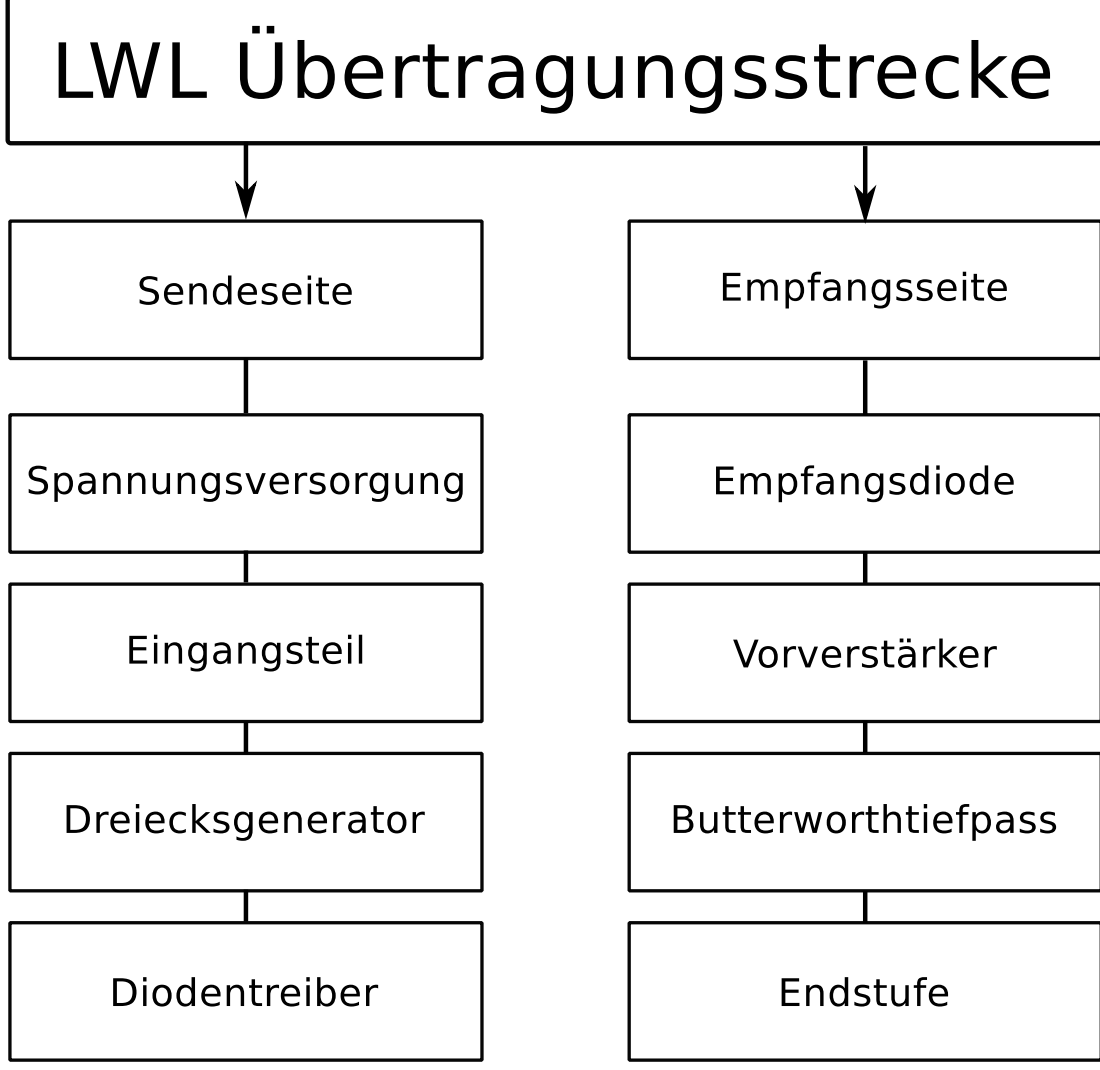
[picture p76: page 1]
