SeriousD/SemesterProjekt/Projektbericht/gfx/system.pdf

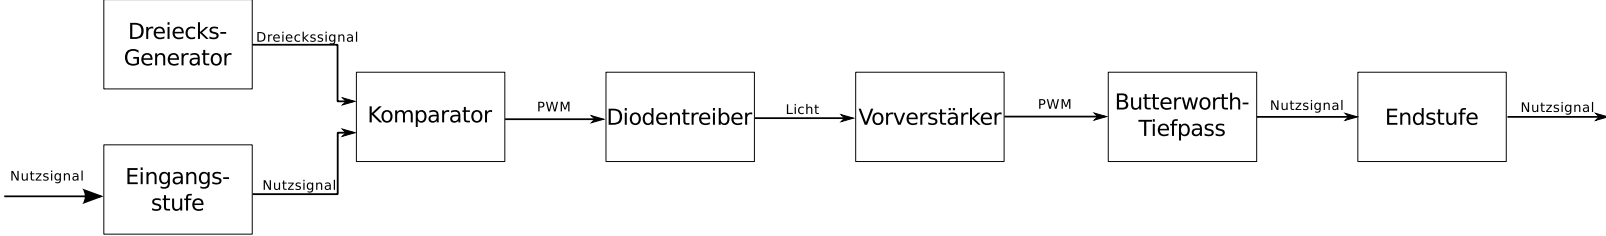
[picture p77: page 1]
