SeriousD/SemesterProjekt/Projektbericht/gfx/modulations/AM_Preview.pdf

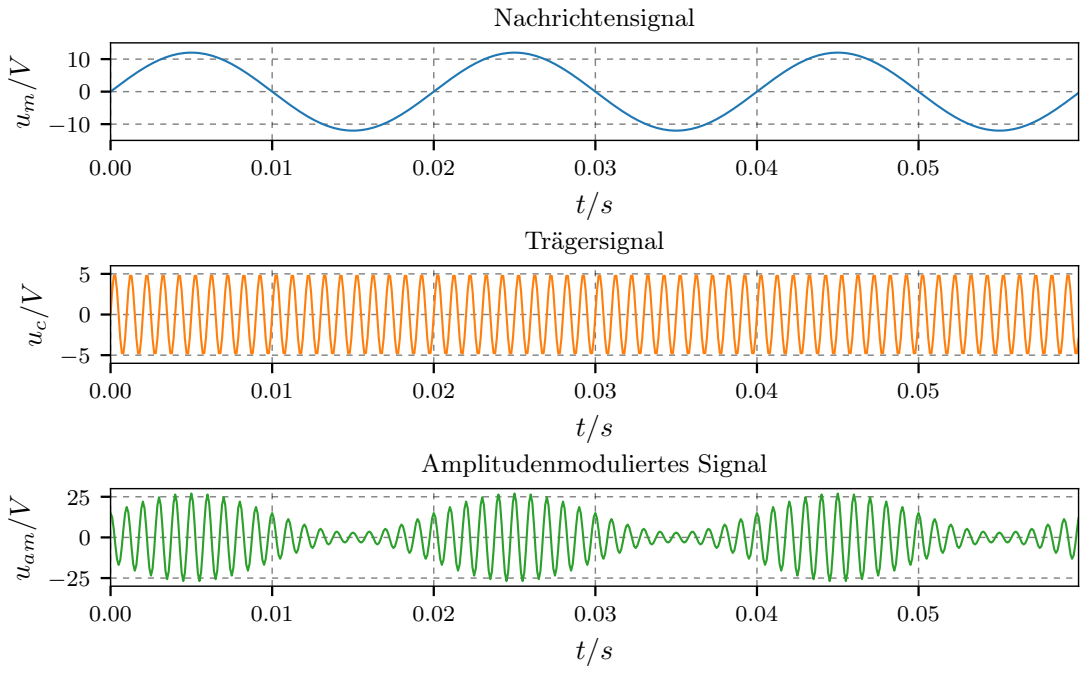
[picture p78: page 1]
Nachrichtensignal; Trägersignal; uam/V; Amplitudenmoduliertes Signal
