SeriousD/SemesterProjekt/Projektbericht/gfx/modulations/FM_Preview.pdf

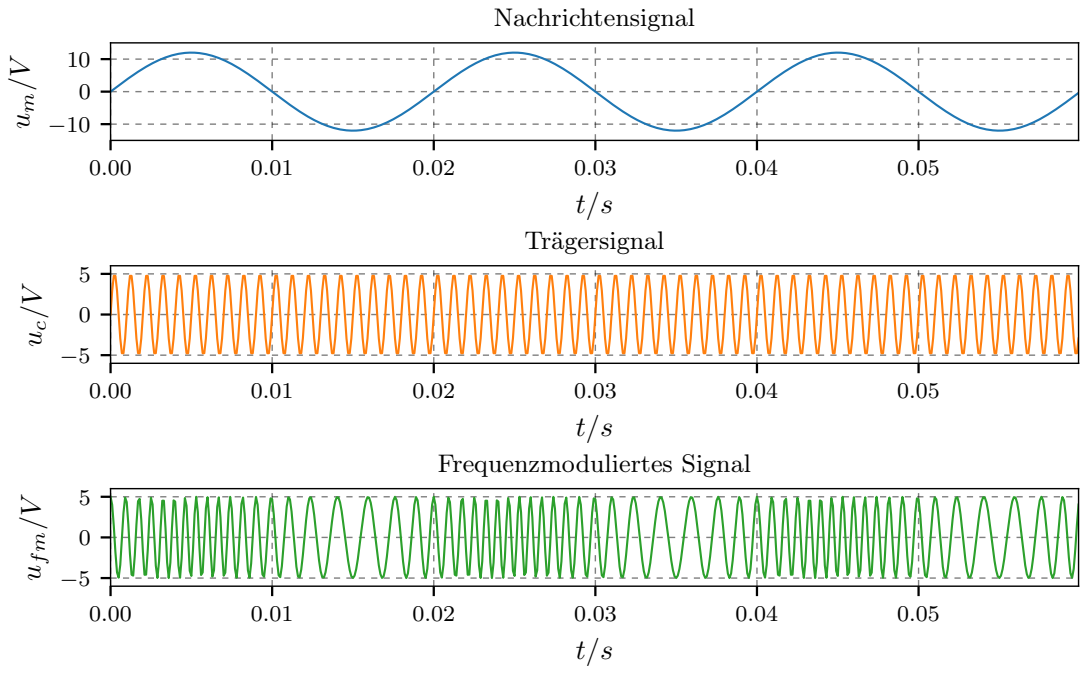
[picture p79: page 1]
Nachrichtensignal; Trägersignal; ufm/V; Frequenzmoduliertes Signal
