SeriousD/SemesterProjekt/Projektbericht/gfx/modulations/PWM_Preview.pdf

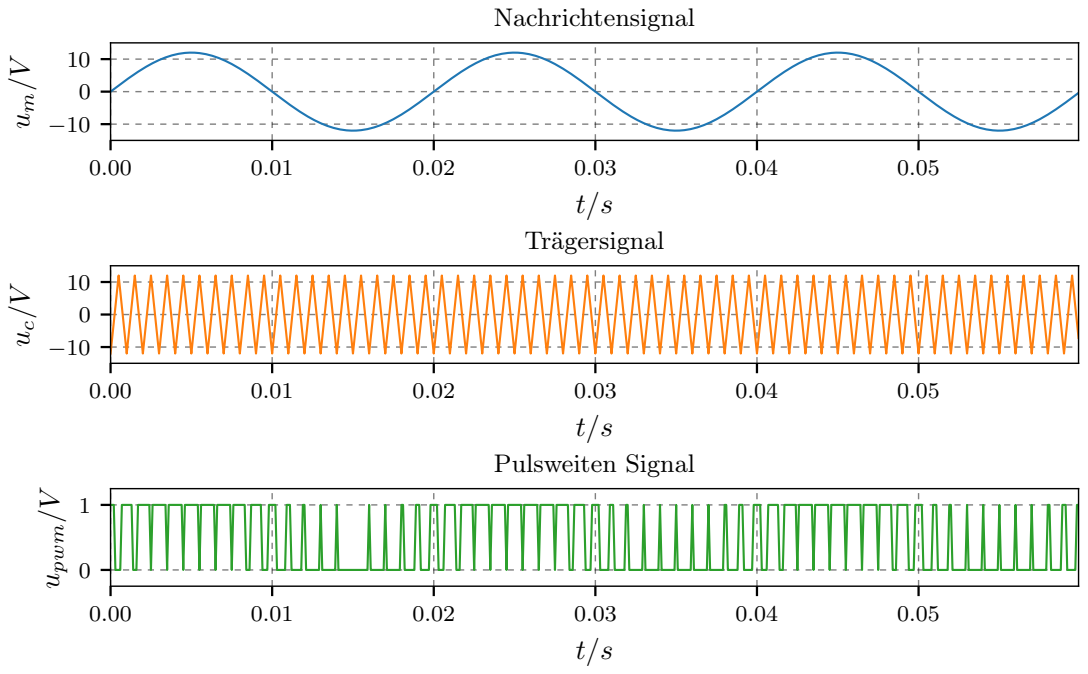
[picture p80: page 1]
Nachrichtensignal; Trägersignal; upwm/V; Pulsweiten Signal
