SeriousD/SemesterProjekt/Projektbericht/gfx/modulations/PWMarea_Preview.pdf

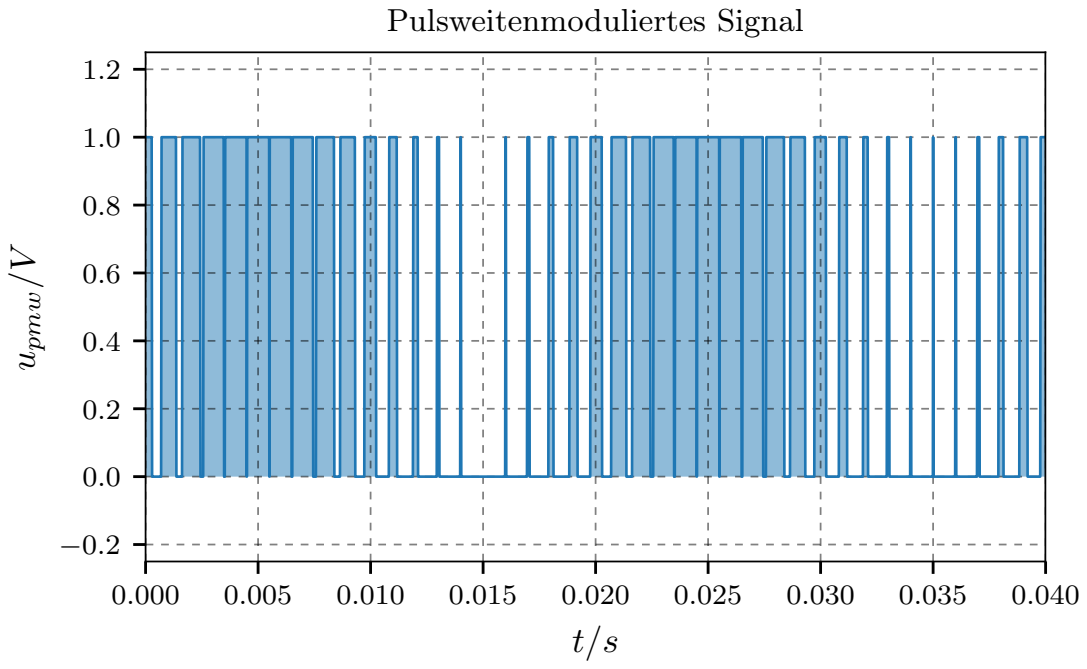
[picture p81: page 1]
upmw/V; Pulsweitenmoduliertes Signal
