SeriousD/SemesterProjekt/Empfangseinheit.pdf

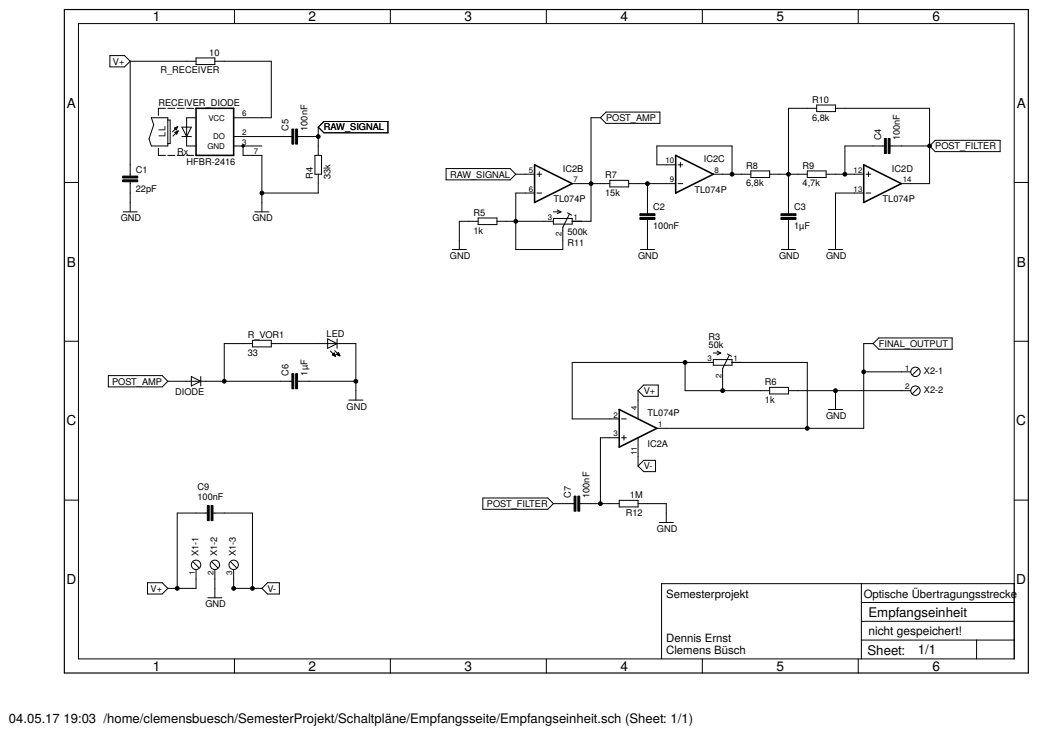
[picture p82: page 1]

04.05.17 19:03 /home/clemensbuesch/SemesterProjekt/Schaltpläne/Empfangsseite/Empfangseinheit.sch (Sheet: 1/1)
