SeriousD/SemesterProjekt/Sendeeinheit.pdf

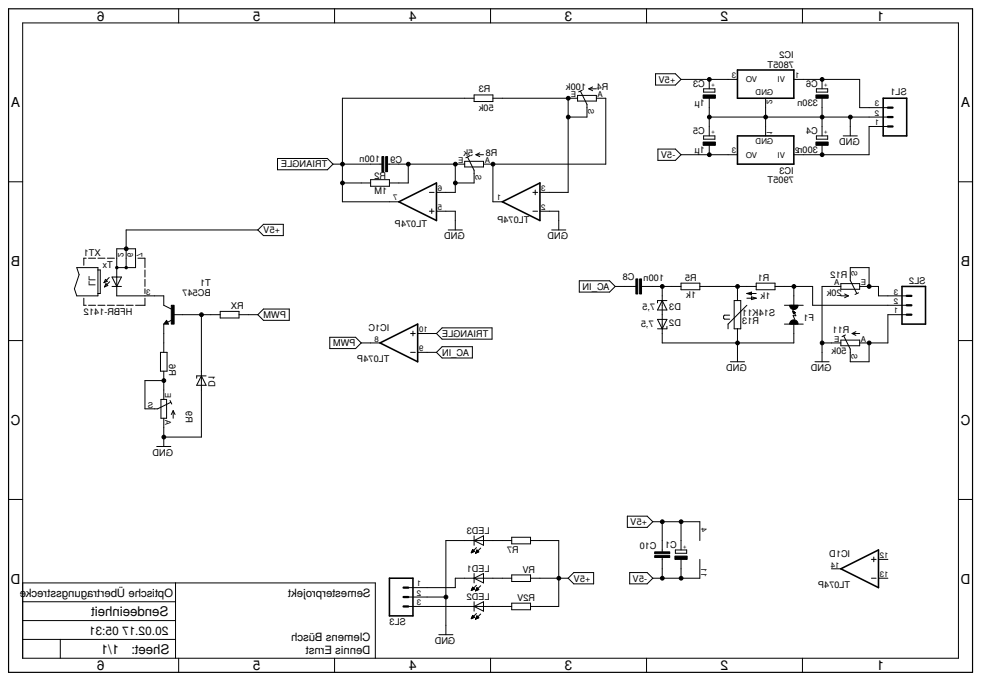
[picture p83: page 1]

ekcert ssgnugartr eb Üehcsit p O

t kej or pr et se meS
