SeriousD/SemesterProjekt/Schaltpläne/Sendeseite/Sendeeinheit.pdf

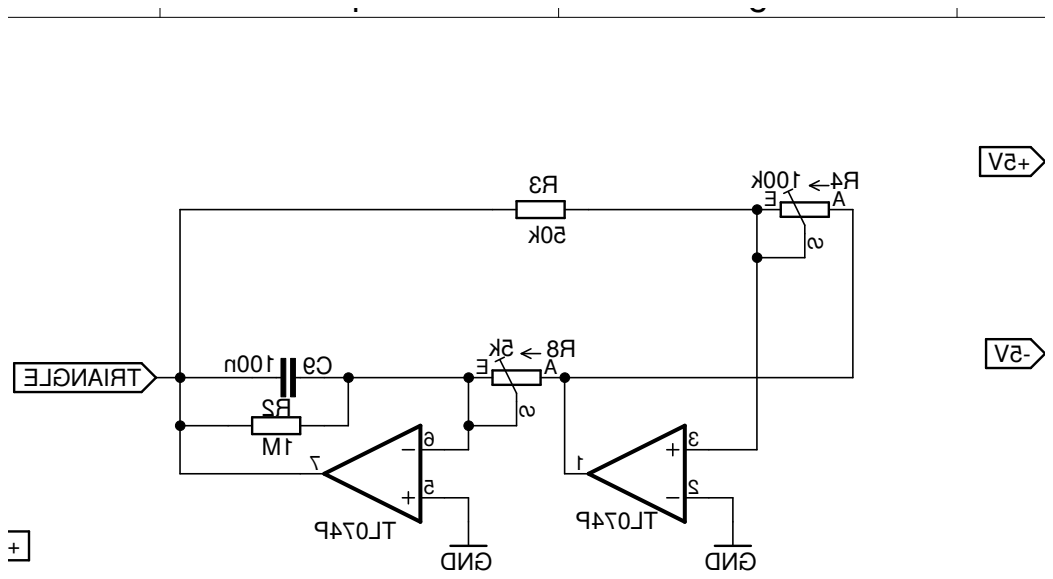
[picture p84: page 1]
