SeriousD/SemesterProjekt/Schaltpläne/Sendeseite/TxLayout.pdf

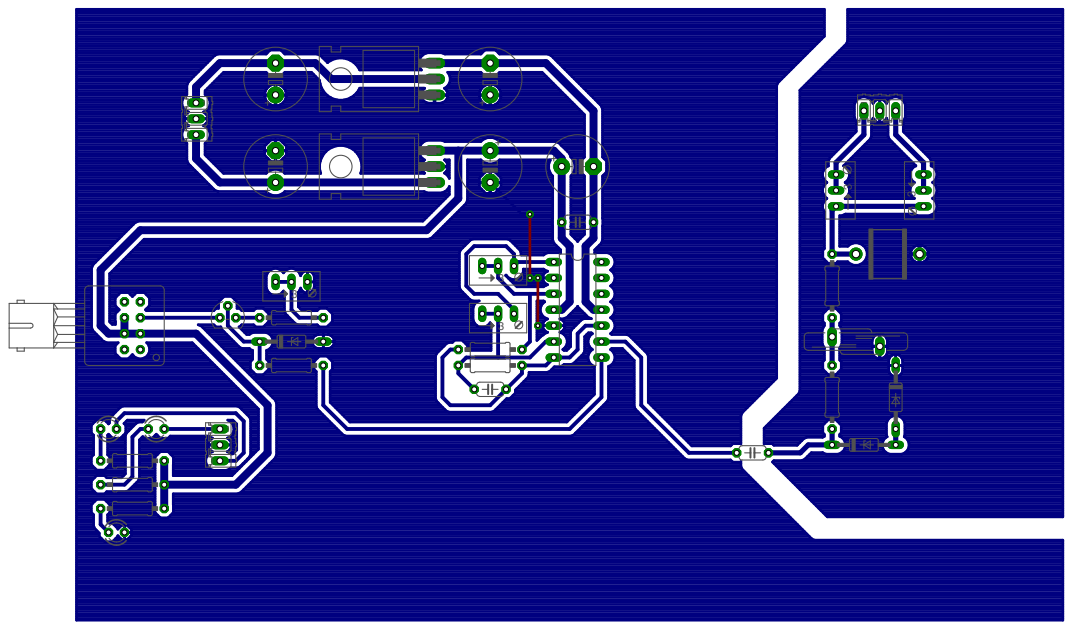
[picture p85: page 1]
