SeriousD/SemesterProjekt/Schaltpläne/Sendeseite/TxSchaltplan.pdf

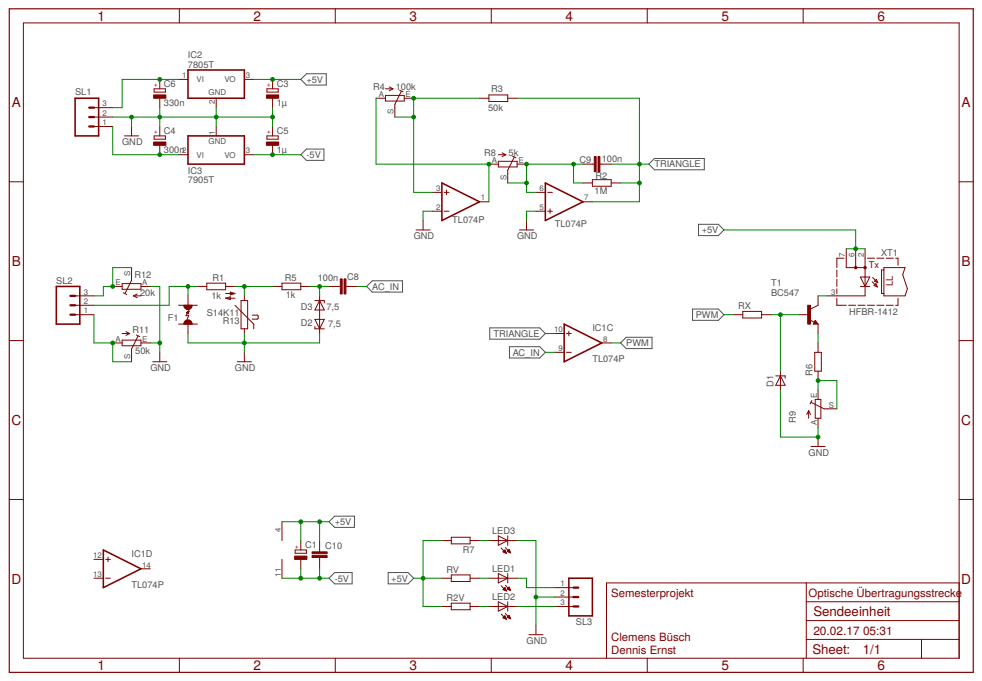
[picture p86: page 1]
