SeriousD/SemesterProjekt/Schaltpläne/Empfangsseite/RxLayout.pdf

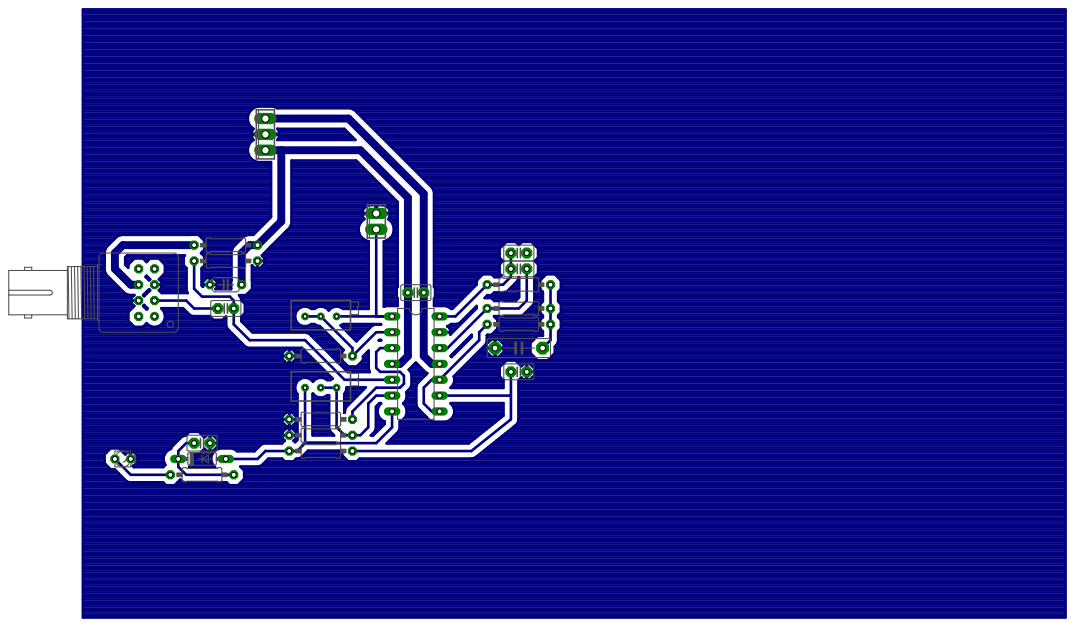
[picture p87: page 1]
