SeriousD/SemesterProjekt/Schaltpläne/Empfangsseite/RxSchaltplan.pdf

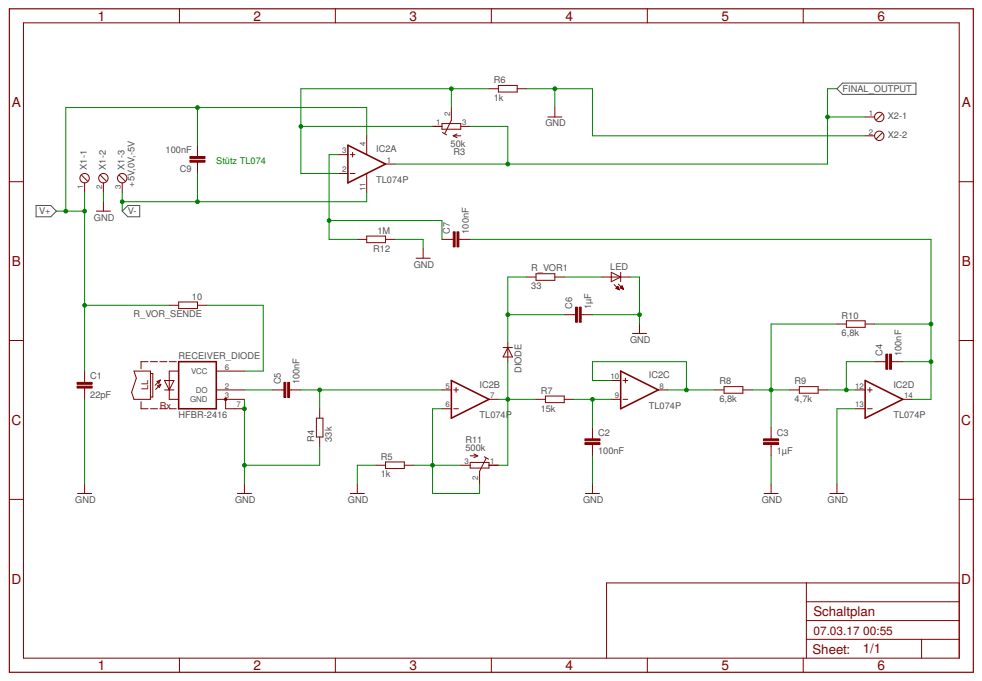
[picture p88: page 1]

VCC
