SeriousD/SemesterProjekt/Simulation/Clemens Simulationen/Empfangsseite_Test_Dennis.asc

C1: cap; 100n
C2: cap; 1µ
C3: cap; 100n
C5: cap; 1µ
C6: cap; 100n
D1: diode
D2: LED
R1: res; 15k
R2: res; 6,8k
R3: res; 6,8k
R4: res; 4,7k
R5: res; 1k
R6: res; 33k
R7: res; 500k
R8: res; 33
R9: res; 1Meg
R10: res; 1k
R11: res; 50k
U1: opamp2; TL074
U2: opamp2; TL074
U3: opamp2; TL074
U4: opamp2; TL074
V1: voltage; PULSE(0 5 0 0.5*f 0.5*f 5 1/f 10)
V2: voltage; 5
V3: voltage; 5
Named nets: 0, V+, V-
.tran 160ms
.inc TL074.301
.param f 1k
