SeriousD/SemesterProjekt/Simulation/Denise Simulationen/simEingang.asc

D2: zener; EDZV7_5B
D4: zener; EDZV7_5B
R8: res; 280MegR
R9: res; 20kR
R11: res; 1000R
R12: res; 1000R
U4: neonbulb
V3: signal; SINE(0 {U} 50)
Named nets: 0
.tran 0 0.022 0.002
.step param U 10k 100k 10k
