SeriousD/SemesterProjekt/Simulation/Denise Simulationen/simTotal.asc

C1: cap; 0.1µ
C2: cap; 10n
C4: cap; 100n
C5: cap; 1µ
C6: cap; 100n
C7: cap; 100n
C8: cap; 1µ
C9: cap; 100n
D1: zener; BZX84C6V2L
D3: LED; QTLP690C
D5: diode
D6: LED
Q1: npn; BC547C
R1: res; 1meg
R2: res; 60k
R3: res; 90k
R4: res; 500
R5: res; 68R
R6: res; 120
R7: res; 50
R10: res; 15k
R13: res; 6,8k
R14: res; 6,8k
R15: res; 4,7k
R16: res; 33k
R17: res; 1k
R18: res; 500k
R19: res; 33
R20: res; 1Meg
R21: res; 1k
R22: res; 10k
U1: TL074
U2: TL074
U3: TL074
U4: TL074
U5: TL074
U6: TL074
U7: TL074
V1: voltage; 9
V2: voltage; 9
V3: signal; SINE(0 4V 50); AC 1
V5: voltage; 5
V6: voltage; 5
Named nets: 0, V+, V-, out
;tran 0 0.20 0.02 10u
;.step param R 0.1 100 10
;.inc TL074.301
.ac dec 100 1 100k
