SeriousD/SemesterProjekt/Simulation/Denise Simulationen/sim.asc

A1: varistor; 25
C1: cap; 0.1µ
C2: cap; 10n
C3: cap; 100nF
D1: zener; BZX84C6V2L
D2: zener; EDZV7_5B
D3: LED; QTLP690C
D4: zener; EDZV7_5B
Q1: npn; BC547C
R1: res; 1meg
R2: res; 60k
R3: res; 90k
R4: res; 5000
R5: res; 68R
R6: res; 120
R7: res; 50
R8: res; 280MegR
R9: res; 20kR
R11: res; 1kR
R12: res; 1kR
U1: TL074
U2: TL074
U3: TL074
U4: neonbulb
V1: voltage; 9
V2: voltage; 9
V3: signal; SINE(0 100kV 50)
Named nets: 0
.tran 0 0.024 0.02
;.step param R 0.1 100 10
