SeriousD/SemesterProjekt/Simulation/Clemens Simulationen/AlterFilter.asc

C1: cap; 100n
C2: cap; 1µ
C3: cap; 100n
R1: res; 15k
R2: res; 6,8k
R3: res; 6,8k
R4: res; 4,7k
U1: TL074
U3: TL074
V1: voltage; SINE(0 1); AC 1
V2: voltage; 5
V3: voltage; 5
Named nets: 0, V+, V-
;tran 160ms
.ac dec 100 1 10k
