SeriousD/SemesterProjekt/Schaltpläne/Sendeseite/Sendeeinheit.brd

## EAGLE design Schaltpläne/Sendeseite/Sendeeinheit.brd (2017-05-04)

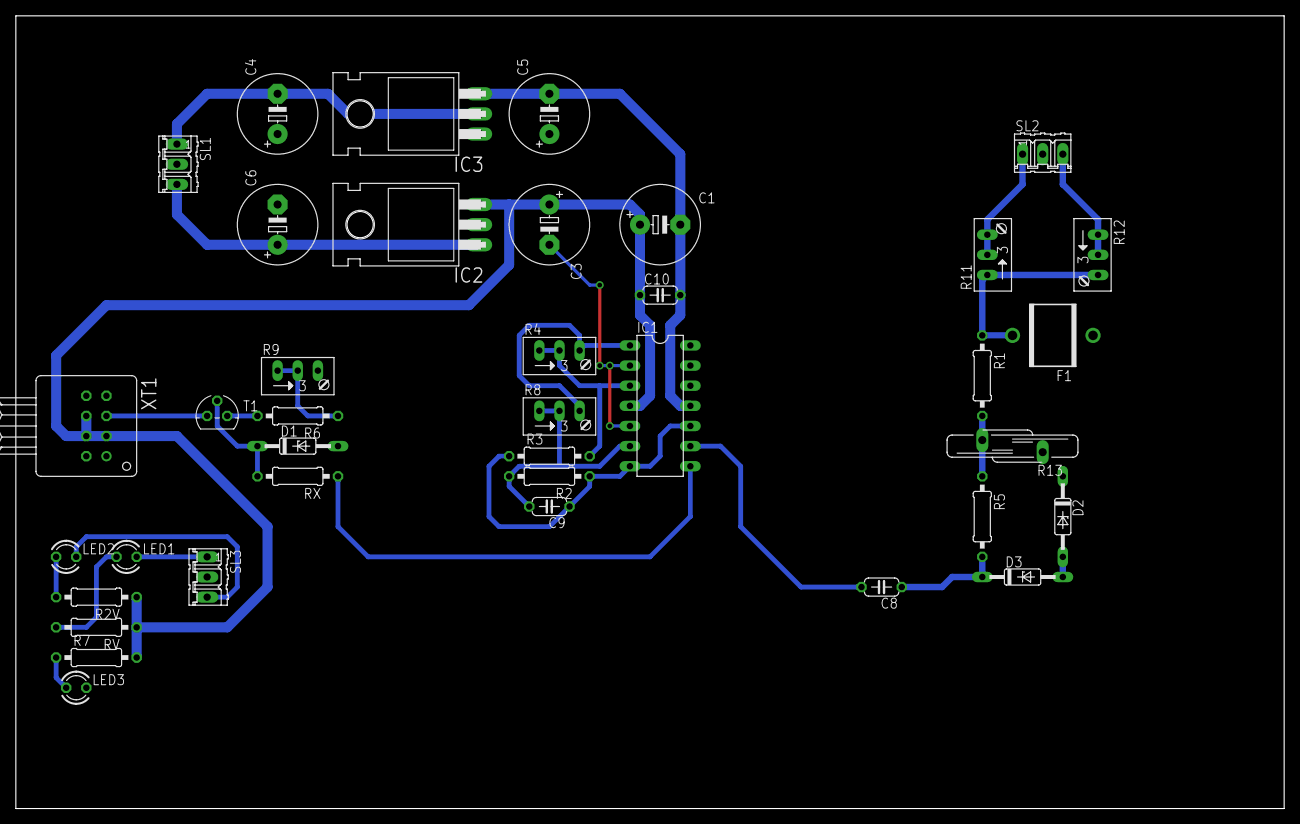
[picture p89: board Sendeeinheit.brd from above]

Board: 2 copper layers, 160.0 x 100.0 mm, 38 parts (0 on the bottom side), 26 nets.

Parts:
C1: E5-10,5
C3, C5: 1µ; E5-10,5
C4: 300n; E5-10,5
C6: 330n; E5-10,5
C8, C10: C050-024X044
C9: 100n; C050-024X044
D1: DO35Z10
D2, D3: 7,5; DO35Z10
F1: EPCOS_N81
IC1: TL074P; DIL14
IC2: 7805T; TO220H
IC3: 7905T; TO220H
LED1, LED2, LED3: LED3MM
R1, R5: 1k; 0207/10
R2: 1M; 0207/10
R2V, R6, R7: 0207/10
R3: 50k; 0207/10
R4: 100k; RJ9W
R8: 5k; RJ9W
R9: RJ9W
R11: 50k; RJ9W
R12: 20k; RJ9W
R13: S14K11
RV: 0207/10
RX: 0207/10
SL1, SL2, SL3: 03P
T1: BC547; TO92
XT1: HFBR-1412; HFBR-X41X

Connections:
+5V: C1.+, C3.+, C10.1, IC1.4, IC2.3, R2V.1, R7.2, RV.1, XT1.2, XT1.6, XT1.7
-5V: C1.-, C5.-, C10.2, IC1.11, IC3.3
AC_IN: C8.2, IC1.9
GND: C3.-, C4.+, C5.+, C6.-, D1.A, D2.C, F1.1, IC1.2, IC1.5, IC2.2, IC3.1, LED3.K, R9.A, R13.1, SL1.2, SL2.2, SL3.2
unnamed: C6.+, IC2.1, SL1.3
unnamed: C4.-, IC3.2, SL1.1
unnamed: R12.E, R12.S, SL2.3
unnamed: R11.A, R11.S, SL2.1
unnamed: F1.2, R1.1, R11.E, R12.A
unnamed: D2.A, D3.A
unnamed: R1.2, R5.1, R13.2
unnamed: C8.1, D3.C, R5.2
unnamed: C9.2, IC1.6, R2.2, R8.E, R8.S
unnamed: LED2.K, SL3.3
unnamed: LED1.K, SL3.1
unnamed: LED2.A, R2V.2
unnamed: LED1.A, RV.2
unnamed: LED3.A, R7.1
unnamed: IC1.1, R4.A, R8.A
unnamed: IC1.3, R3.2, R4.E, R4.S
unnamed: T1.3, XT1.3
unnamed: D1.C, RX.2, T1.2
unnamed: R6.2, T1.1
unnamed: R6.1, R9.E, R9.S
PWM: IC1.8, RX.1
TRIANGLE: C9.1, IC1.7, IC1.10, R2.1, R3.1
