SeriousD/SemesterProjekt/Schaltpläne/Empfangsseite/Empfangseinheit.brd

## EAGLE design Schaltpläne/Empfangsseite/Empfangseinheit.brd (2017-05-02)

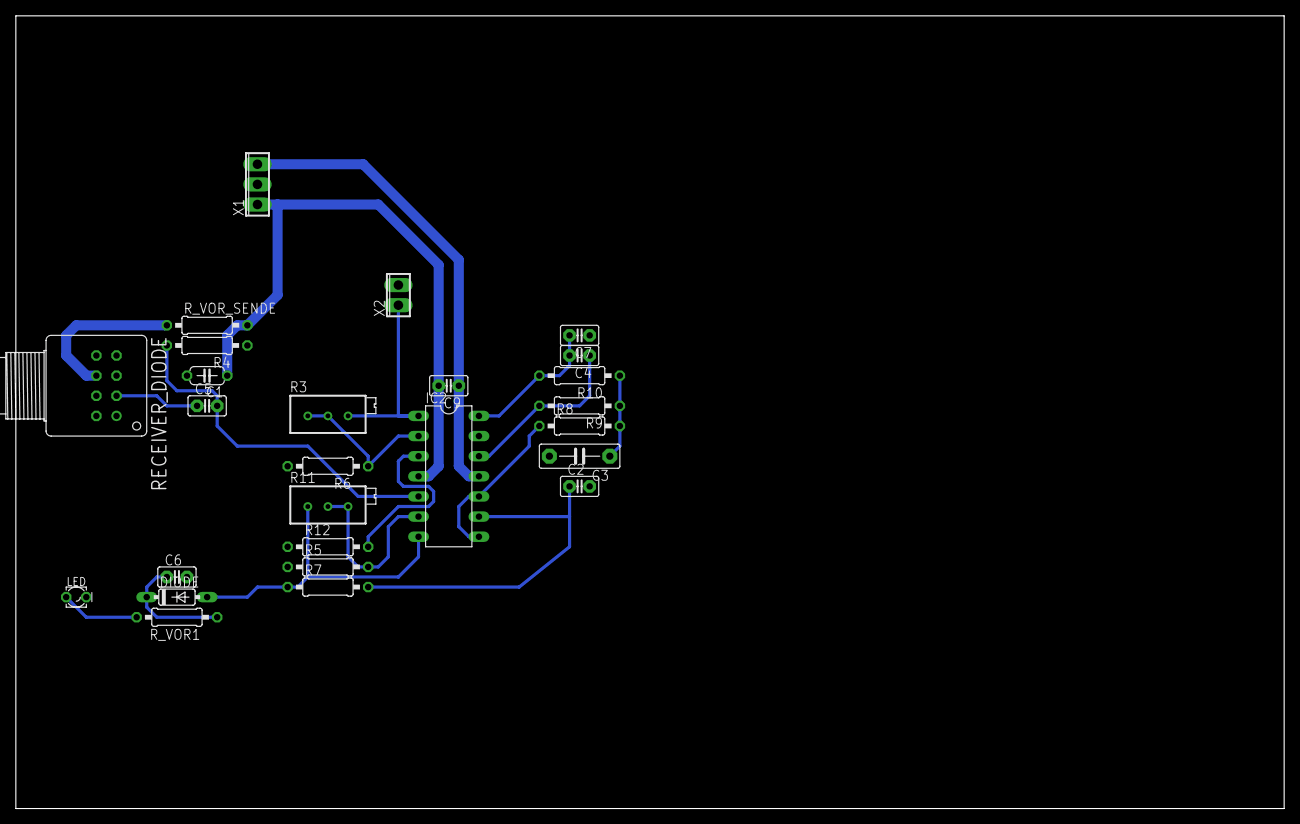
[picture p90: board Empfangseinheit.brd from above]

Board: 2 copper layers, 160.0 x 100.0 mm, 26 parts (0 on the bottom side), 18 nets.

Parts:
C1: 22pF; C050-024X044
C2, C4, C5, C7, C9: 100nF; C2.5-2
C3: 1µF; C7.5B3
C6: 1µF; C2.5-2
DIODE: DIODE_DO35-7
IC2: TL074P; DIL14
LED: LED_LD260
R3: 50k; RTRIMT93XA
R4: 33k; 0207/10
R5, R6: 1k; 0207/10
R7: 15k; 0207/10
R8, R10: 6,8k; 0207/10
R9: 4,7k; 0207/10
R11: 500k; RTRIMT93XA
R12: 1M; 0207/10
RECEIVER_DIODE: HFBR-2416
R_VOR1: 33; 0207/10
R_VOR_SENDE: 10; 0207/10
X1: +5V,0V,-5V; 3POL254
X2: 2POL254

Connections:
FINAL_OUTPUT: IC2.1, R3.3, X2.1
FINAL_SIGNAL: IC2.2, R3.1, R3.2, R6.1
GND: C1.2, C2.2, C3.2, C6.2, IC2.13, LED.K, R4.1, R5.1, R6.2, R12.1, RECEIVER_DIODE.3, RECEIVER_DIODE.7, X1.2, X2.2
unnamed: C3.1, R8.2, R9.1, R10.1
unnamed: C4.1, IC2.12, R9.2
unnamed: C5.1, RECEIVER_DIODE.2
unnamed: IC2.6, R5.2, R11.2, R11.3
unnamed: C5.2, IC2.5, R4.2
unnamed: C2.1, IC2.9, R7.2
unnamed: C6.1, DIODE.C, R_VOR1.1
unnamed: RECEIVER_DIODE.6, R_VOR_SENDE.1
unnamed: C7.1, IC2.3, R12.2
unnamed: IC2.8, IC2.10, R8.1
unnamed: LED.A, R_VOR1.2
POST_AMP: DIODE.A, IC2.7, R7.1, R11.1
POST_FILTER: C4.2, C7.2, IC2.14, R10.2
V+: C1.1, C9.2, IC2.4, R_VOR_SENDE.2, X1.1
V-: C9.1, IC2.11, X1.3
