SeriousD/SemesterProjekt/Schaltpläne/Sendeseite/SchaltplanV2.brd

## EAGLE design Schaltpläne/Sendeseite/SchaltplanV2.brd (2016-11-13)

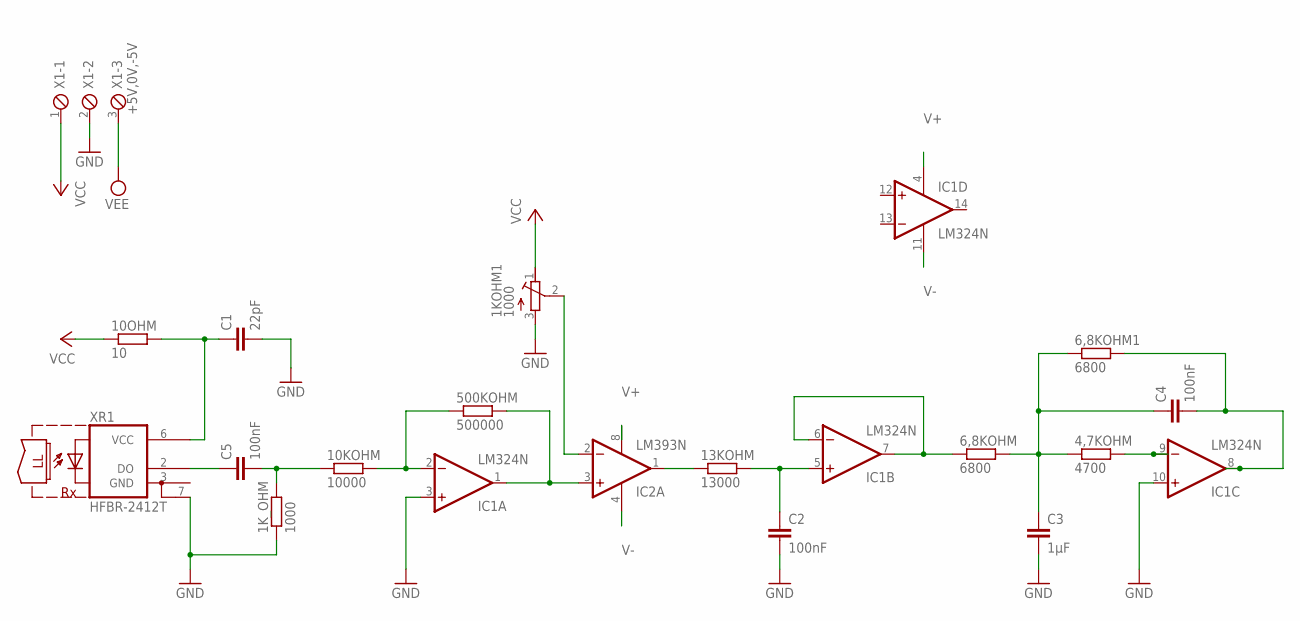
[picture p91: schematic SchaltplanV2.sch]

Parts:
1KOHM1: 1000; RTRIMT93XA
1K_OHM: 1000; 0309/12
4,7KOHM: 4700; 0309/12
6,8KOHM, 6,8KOHM1: 6800; 0309/12
10KOHM: 10000; 0309/12
10OHM: 10; 0309/12
13KOHM: 13000; 0309/12
500KOHM: 500000; 0309/12
C1: 22pF; C050-024X044
C2, C4, C5: 100nF; C2.5-2
C3: 1µF; C7.5B3
IC1: LM324N; DIL14
IC2: LM393N; DIL08
X1: +5V,0V,-5V; 3POL254
XR1: HFBR-2412T; HFBR-X41XT

Connections:
GND: 1KOHM1.3 (E), 1K_OHM.1, C1.2, C2.2, C3.2, IC1.3 (+IN), IC1.10 (+IN), X1.2, XR1.3 (GND), XR1.7 (GND1)
unnamed: 4,7KOHM.1, 6,8KOHM.2, 6,8KOHM1.1, C3.1, C4.1
unnamed: 4,7KOHM.2, IC1.9 (-IN)
unnamed: C5.1, XR1.2 (DO)
unnamed: 10OHM.2, C1.1, XR1.6 (VCC)
unnamed: 1K_OHM.2, 10KOHM.1, C5.2
unnamed: 500KOHM.2, IC1.1 (OUT), IC2.3 (+IN)
unnamed: 1KOHM1.2 (S), IC2.2 (-IN)
unnamed: 13KOHM.1, IC2.1 (OUT)
unnamed: 10KOHM.2, 500KOHM.1, IC1.2 (-IN)
unnamed: 13KOHM.2, C2.1, IC1.5 (+IN)
unnamed: 6,8KOHM.1, IC1.6 (-IN), IC1.7 (OUT)
unnamed: 6,8KOHM1.2, C4.2, IC1.8 (OUT)
V+: 1KOHM1.1 (A), 10OHM.1, IC1.4 (V+), IC2.8 (V+), X1.1
V-: IC1.11 (V-), IC2.4 (V-), X1.3

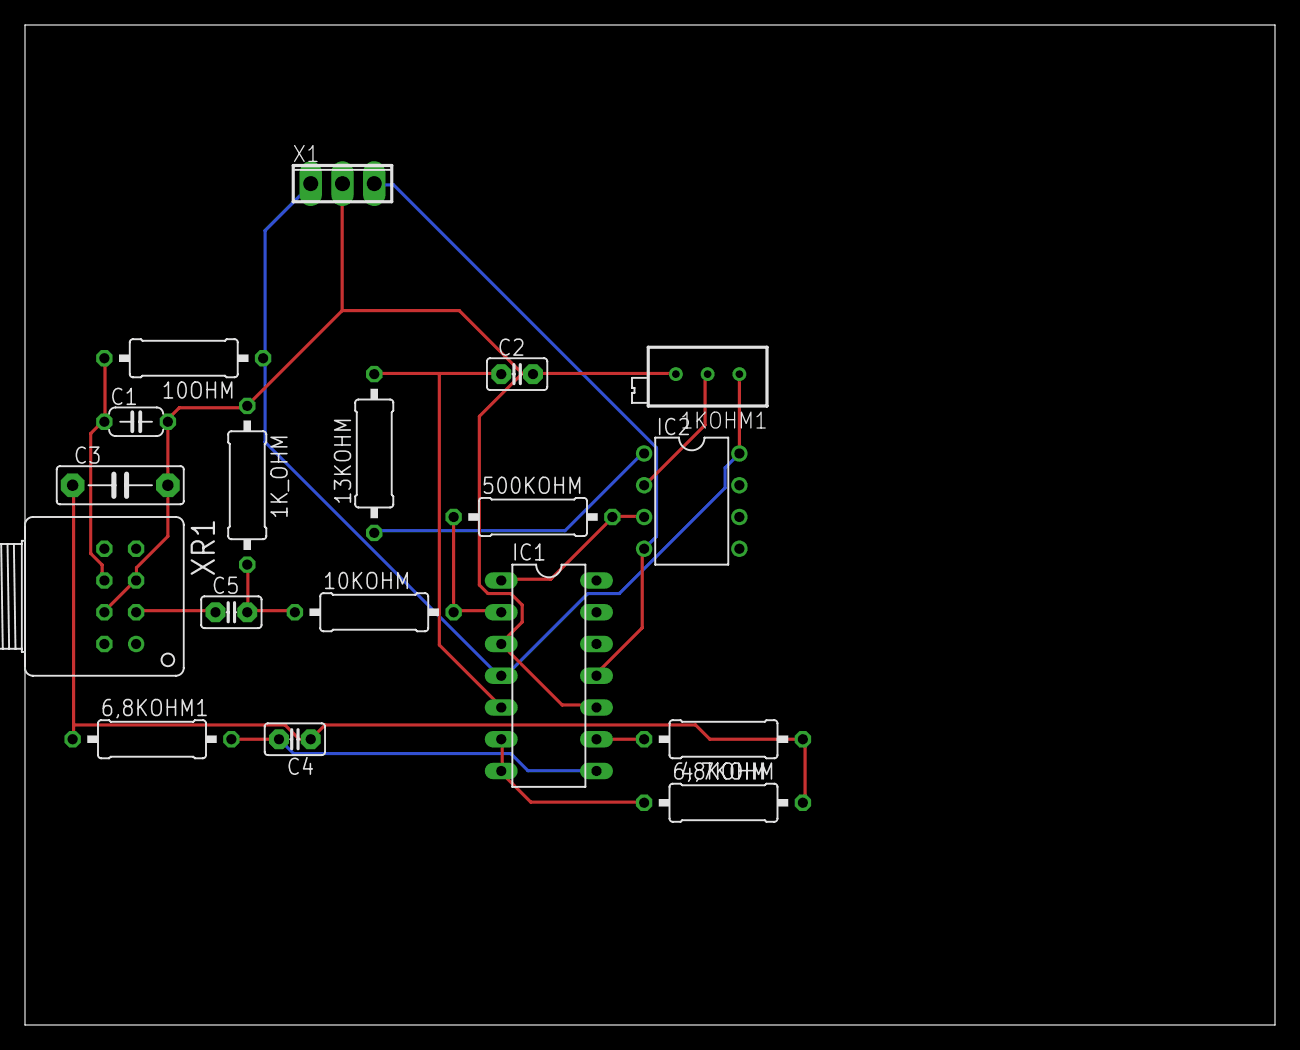
[picture p92: board SchaltplanV2.brd from above]

Board: 2 copper layers, 100.0 x 80.0 mm, 18 parts (0 on the bottom side), 15 nets.
