SeriousD/SemesterProjekt/(commit log)

2016-11-13 simulationen
    meins und deins <3
2016-11-13 Added Schematics
    Dunno which..
    [Schaltplan.sch, SchaltplanV1.brd, SchaltplanV2.brd, SchaltplanV2.sch]
2016-11-16 added schematic, and new simulation version
    new TL074 include to ensure the simulation won't fail because of false includes. still takes too long to simulate
    [Schaltplan.sch]
2017-05-02 updated schematics
    Rx,Tx
    [Schaltplan.brd]
2017-05-04 add final Tx schematic
    [Sendeeinheit.brd, Sendeeinheit.sch]
2017-05-04 Schematics updated
    Empfangseinheit baby
    [Empfangseinheit.brd, Empfangseinheit.sch]
2017-05-15 added csv's
    [100kV.csv, 30kV.csv]
2017-05-25 fuse branches
    keep Anleitung up to date
2017-05-26 bestimmtheitsmaß
    berechnung per excel, formeln kommen im späteren commit
    [100kV_rechnung.csv, 30kV_Rechnung.csv]
2017-05-27 add Kal
    [messung28k.csv, messung8k4.csv]
2017-05-27 add justification
    [100kV.csv, 30kV.csv, messung28k.csv, messung8k4.csv]
2017-05-29 improve plot&calc
    prettier plots, automatic CSV loading etc.
    [2k97.csv, 9k89.csv, messung28k.csv, messung8k4.csv]
2017-05-30 add sexy plots
    [AM.csv, FM.csv, PWM.csv, PWMarea.csv]
2017-05-30 delete obsolete files
    since there are new sexy plots, the old errorous plots aren't needed anymore. Also deleted old wrong copied folders and files
    [messung28k.csv, messung8k4.csv]
2017-05-30 update sexy plots and modify plot script
    another part in the plot script were needed for the pwm area graphic
2017-06-11 calculation of the coefficient of determination
    all calculations done, AGAIN (no rescue was successful)
    [Alle_Rechnungen.ods]
